VerticalFarmIB3/VerticalFarmIB3.github.io/README.md

Vertical farm - IB3 documentation and webpages
