VerticalFarmIB3/VerticalFarmIB3.github.io/index.md

---
title: Vertical farm - IB3
---

[**Home**](https://verticalfarmib3.github.io/) - [**LEDs and PCB**](/inhoud/leds/) - [**LED Control and Sources**](/inhoud/aansturingLEDs/) - [**Energy Monitoring**](/inhoud/energiemonitoring/) - [**Water Supply**](/inhoud/aquaMonitoring/) - [**Dashboard**](/inhoud/dashboard/) - [**Modularity**](/inhoud/modulariteit/) - [**Plant Sensing**](/inhoud/plantensensor/) - [**Operation**](/inhoud/operation/) - [**Logbook**](/inhoud/logboek/)

---

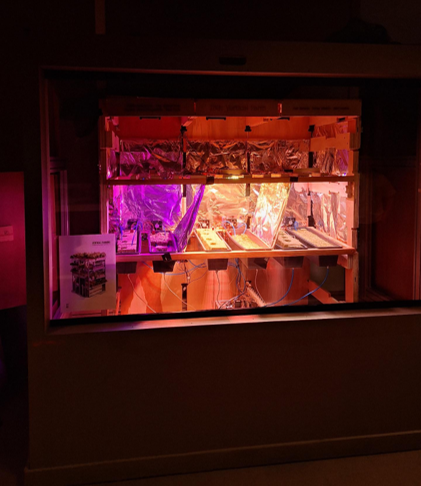
[picture p1: inhoud/images/verticalfarmcloset.png]
