VerticalFarmIB3/VerticalFarmIB3.github.io/inhoud/modulariteit/index.md

---
title: Modularity
---

[**Home**](https://verticalfarmib3.github.io/) - [**LEDs and PCB**](/inhoud/leds/) - [**LED Control and Sources**](/inhoud/aansturingLEDs/) - [**Energy Monitoring**](/inhoud/energiemonitoring/) - [**Water Supply**](/inhoud/aquaMonitoring/) - [**Dashboard**](/inhoud/dashboard/) - [**Modularity**](/inhoud/modulariteit/) - [**Plant Sensing**](/inhoud/plantensensor/) - [**Operation**](/inhoud/operation/) - [**Logbook**](/inhoud/logboek/)

---

The vertical farm is set up in different levels. These are, however, modular and can simply be switched by sliding an entire frame out of a slot. The cables might need to be readjusted, however. A convenient way to increase modularity further could be by working with banana plugs, making every level hot-pluggable.
