VerticalFarmIB3/VerticalFarmIB3.github.io/inhoud/logboek/index.md

---
title: Logbook
---

[**Home**](https://verticalfarmib3.github.io/) - [**LEDs and PCB**](/inhoud/leds/) - [**LED Control and Sources**](/inhoud/aansturingLEDs/) - [**Energy Monitoring**](/inhoud/energiemonitoring/) - [**Water Supply**](/inhoud/aquaMonitoring/) - [**Dashboard**](/inhoud/dashboard/) - [**Modularity**](/inhoud/modulariteit/) - [**Plant Sensing**](/inhoud/plantensensor/) - [**Operation**](/inhoud/operation/) - [**Logbook**](/inhoud/logboek/)

---

13 februari 2024:

* bedrijfsbezoek

20 februari 2024:

* E-mail verzonden voor gratis samples van rockwool bij Grodan
* Opzoeken CO2-sensor
* Tweedehands (oude pc) ventilatoren + aansturing voor planten te laten bewegen
* Info over LEDS gaan vragen bij Jan Audenaert
* LEDs aangestuurd met labovoeding: stroom bepaald (zie [aansturing lampen](/inhoud/aansturingLEDs/))
 * Opzoekwerk buck convertors (geen resultaat)
 * mmol/(m²*s) info opzoeken
 * Opzoekwerk ion-sensoren/ pompmechanismen

27 februari 2024:

 * Laatste opzoekwerk voor CO2-sensor
 * Nieuwe e-mail naar Grodan
 * ESP-home testen
 * Ventilator aansturen met L298N
 * Opzoekwerk buck-convertor
 * DC-motor aansturen voor propeller
 * Bestellingen geplaatst: ()
 * Testen van step-down buck convertor en boost convertor => deze werken en kunnnen gebruikt worden
 * Research homogene mengsels voor nutrient monitoring
 * Impellerrontwerp + starten 3D-print

 5 maart 2024:

* Netstroom naar convertors (230V AC naar 19V/6A DC)
* Desolderen en meten potentiometers
* Opzoekwerk digitale potentiometers (probleem met nauwkeurigheid)
* Poging om Grodan te contacteren

12 maart 2024:

* contactmoment met Grodan
* begonnen aan frame vertical farm
* klaar met LED bediening, wachten totdat erasmusmundus studenten meer weten over specificaties LED's
* Uitlezen en testen van bestelde sensoren
* PCB plantensensoren gemaakt

19 maart 2024:
* PCB plantensensoren aangepast en afgewerkt
* Grafana geimplementeerd in home assistant
* Automatisaties toegevoegd
* PCB water begonnen
* Frame verder gemaakt

26 maart 2024:
* voorbereiden presentatie
* versnellen maakprocess/deadlines

29 maart 2024:
* [deadlines](../deadlines/index.md) gesteld met de uit te voeren taken

1, 2, 3 april:
* maken PCB voor LEDs(Marta Pozzi & Hayato Nakanishi)
* maken PCB voor LEDs(Yuta & Jualiang)
* PCB's bestellen
* scherm uittesten + raspberry pi herconfiguren (ESPhome, homeassist en mosquitto in dockers steken)
* pcb voor grond, co2 en temperatuursensoren solderen en testen
* opzoekwerk naar ideale waarden paprika en basilicum (temperatuur, luchtvochtigheid, co2, grondvochtigheid)

16 april:
* solderen en uittesten van PCB voor LEDs(Marta Pozzi & Hayato Nakanishi)
* solderen en uittesten van PCB voor LEDs(Yuta & Jualiang)
* solderen en uittesten relais bord voor ventilatorensturing (werkt nog niet)
* op oude home assistant MQTT uitgetest met ESP
* ionen voeding
* ....
* studie uitvoeren voor ontwikkeling van PCB vermogenslogger

23 april:
* testen relais bord voor ventilatorensturing
* hardware beginnen installeren in de kast
* LED drivers selecteren en bestellen
* Ontwikkeling van PCB vermogenslogger en schakelaar
* Bestelling van compontenten voor vermogenslogger

30 april:
* 2 extra bordjes gemaakt voor grondsensor, co2 sensor en luchtvochtigheidssensor
* bordjes programmeren
* pcb's geïnstalleerd in de kast
* installatie LED-arrays en LED-drivers (zorgen voor een volledige cablatie)
* kast voorzien van nodige flexibiliteit qua lichtverdeling

7 mei:
* kabelmanagement in de kast
* grafana + influxDB geïnstalleerd op Pi en setup ervan
* eerste dashboard grafana gemaakt
* solderen LED-array PCB Muneeb
* solderen van vermogenslogger PCB + eerste programmatie om de verschillende onderdelen te testen

8 mei:
* solderen bordjes Muneeb + installatie
* programmatie van een eerste implementatie van de vermogenslogger PCB

10 mei:
* volledige implementatie van de vermogenslogger PCB (correcte cablatie met de de led-drivers)
* het uittesten van correct af/uit schakeling + correcte stroommeting

14 mei:
* Voedingen verbonden 

16 mei:
* !presentatie!
