VerticalFarmIB3/VerticalFarmIB3.github.io/inhoud/energiemonitoring/Blokschema.png

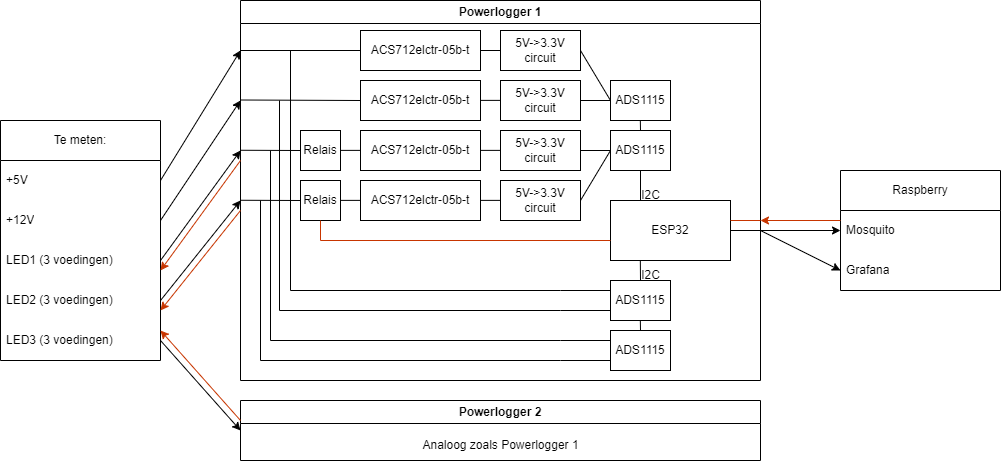
inhoud/energiemonitoring/Blokschema.png
