VerticalFarmIB3/VerticalFarmIB3.github.io/inhoud/energiemonitoring/bordje.jpg

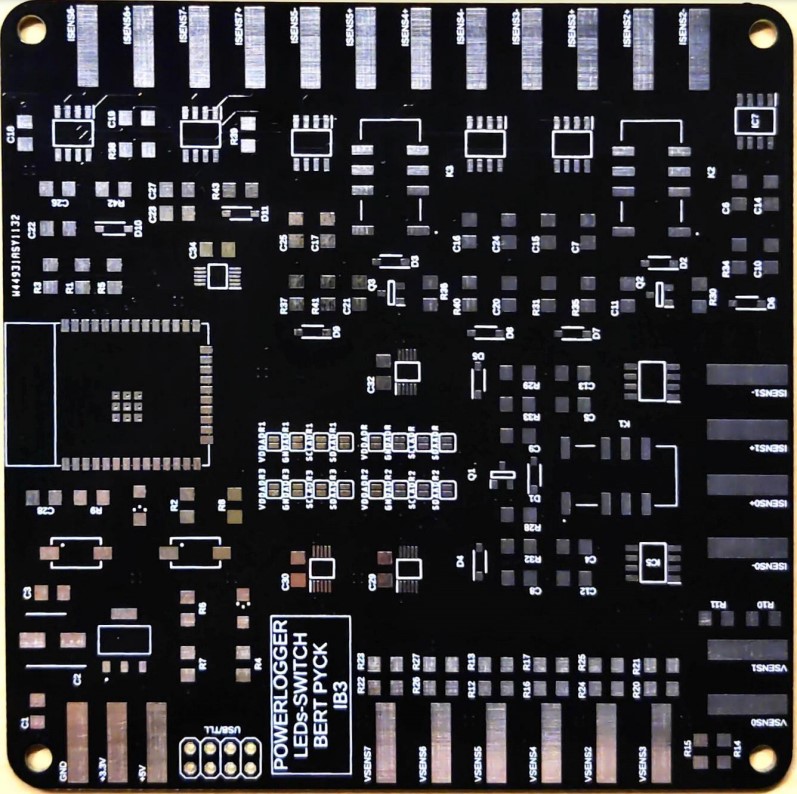
inhoud/energiemonitoring/bordje.jpg
