VerticalFarmIB3/VerticalFarmIB3.github.io/inhoud/energiemonitoring/leds.bmp

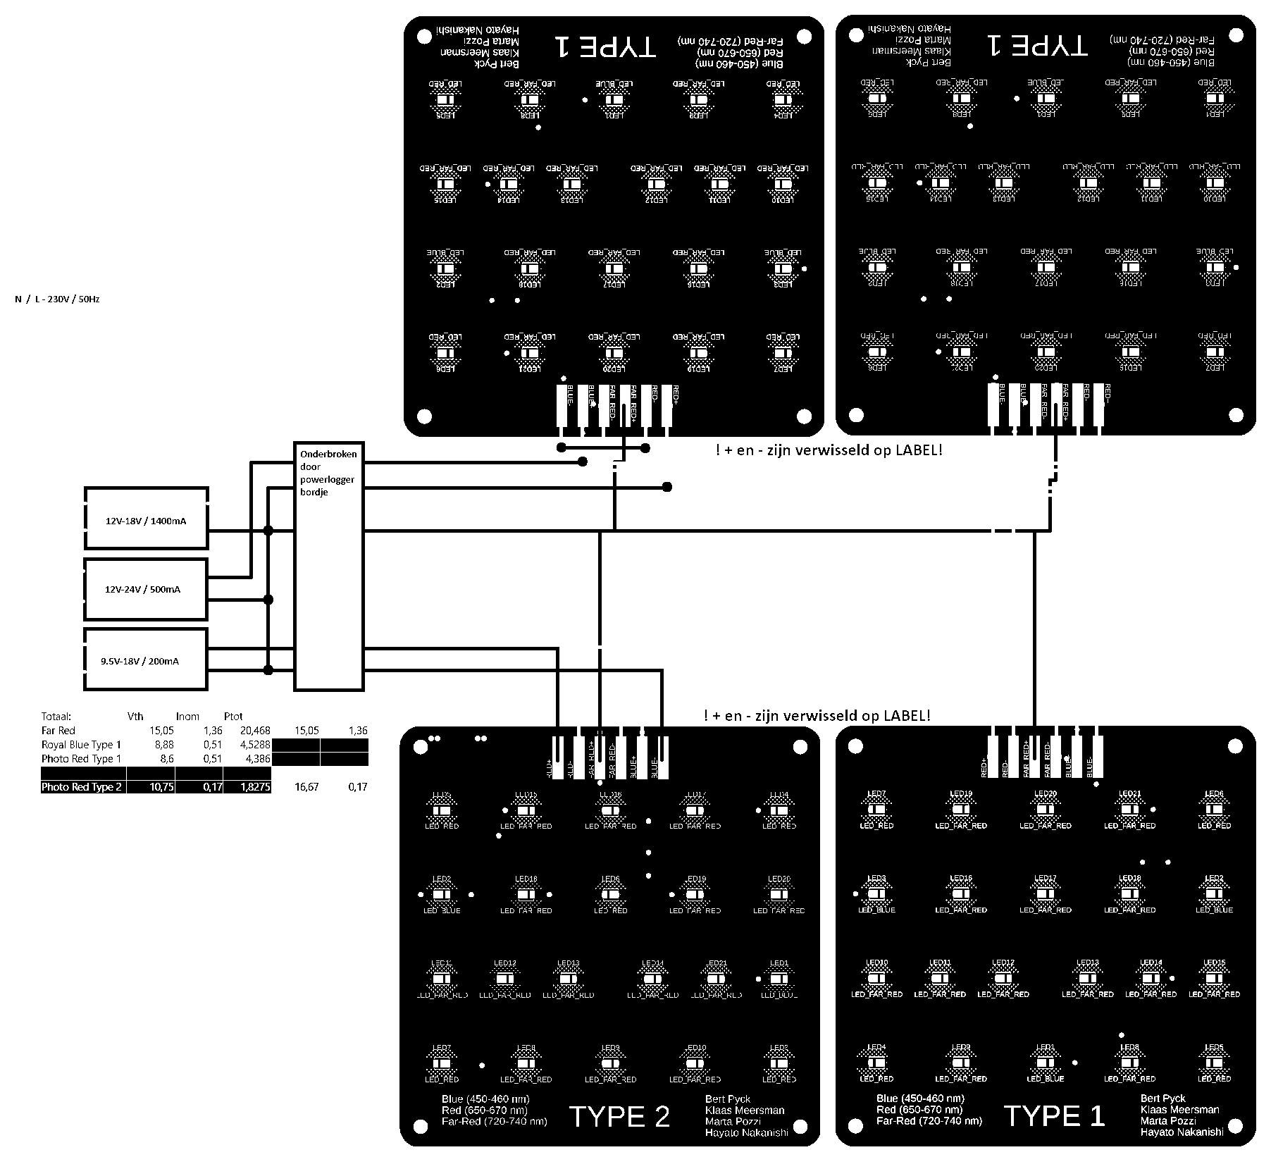
inhoud/energiemonitoring/leds.bmp
