VerticalFarmIB3/VerticalFarmIB3.github.io/inhoud/energiemonitoring/pcb.jpg

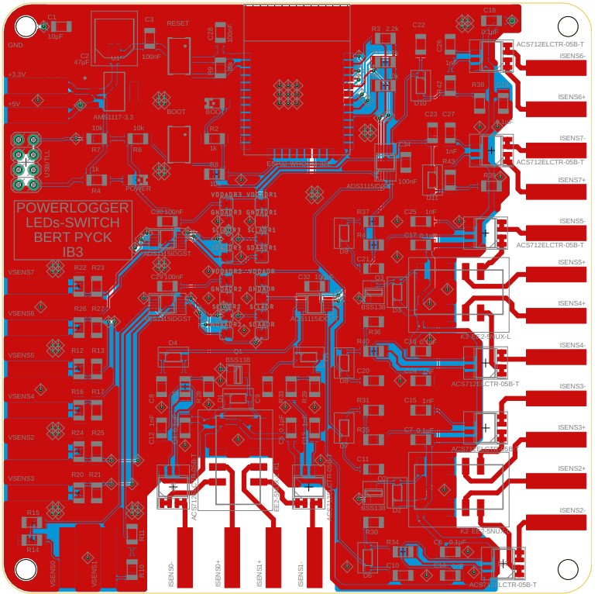
inhoud/energiemonitoring/pcb.jpg
