VerticalFarmIB3/VerticalFarmIB3.github.io/inhoud/energiemonitoring/PCBs Bert (Type1, Type2, Powerlogger)/Type2/Type2afb.png

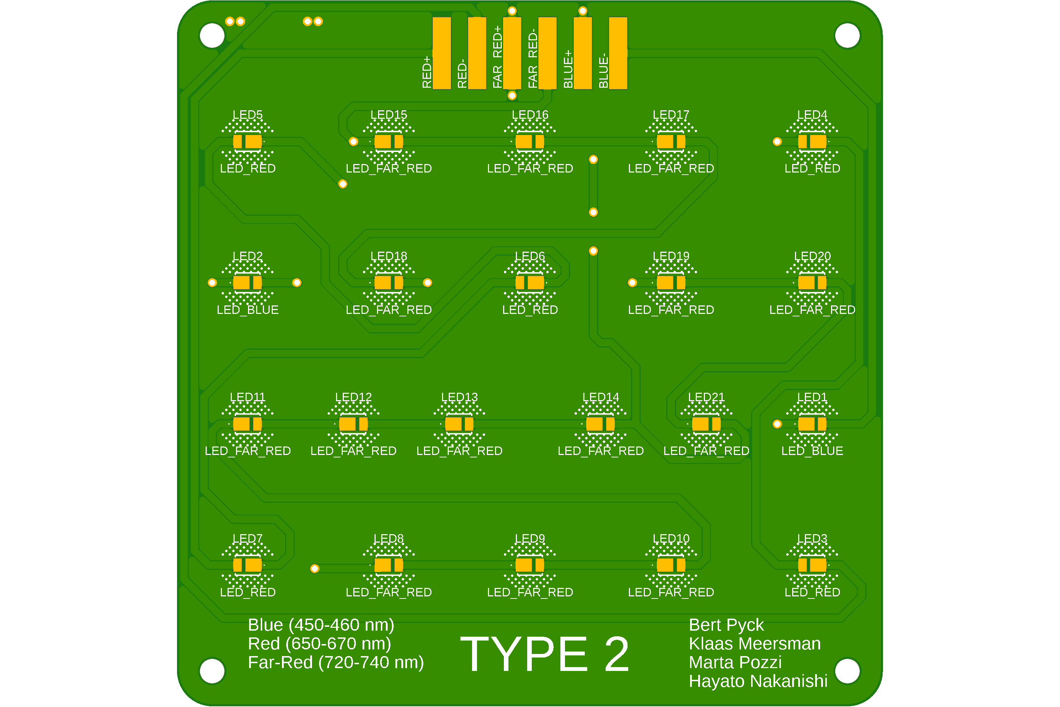
inhoud/energiemonitoring/PCBs Bert (Type1, Type2, Powerlogger)/Type2/Type2afb.png
