VerticalFarmIB3/VerticalFarmIB3.github.io/inhoud/images/mindmap.png

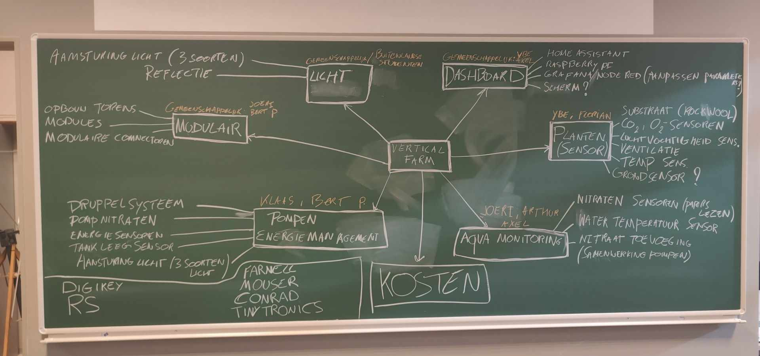
inhoud/images/mindmap.png
