VerticalFarmIB3/VerticalFarmIB3.github.io/inhoud/plantensensor/PCB Plantsensing/PCB_plantensensor.png

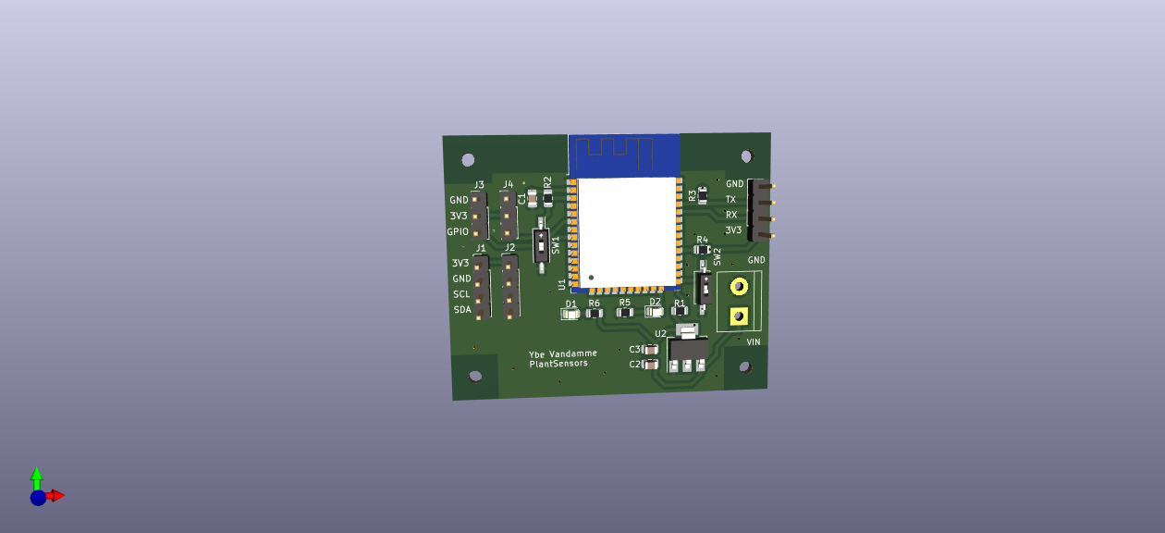
inhoud/plantensensor/PCB Plantsensing/PCB_plantensensor.png
