VerticalFarmIB3/VerticalFarmIB3.github.io/inhoud/bestellingen/Bestellingslijst.xlsx

COMPONENTEN | ACTIE | AANTAL | PRIJS(€) | INFO | LINK | TOTAAL: | 180.65 | €
perestalische pomp | besteld | 9 | 5 | pomp voor het water uit de vistank naar de testtank | Peristaltische Pomp PYSP310-6A - 6V - PYSP310-6A (tinytronics.nl) (https://www.tinytronics.nl/nl/mechanica-en-actuatoren/motoren/pompen/peristaltische-pomp-pysp310-6a-6v)
lichtsensor | kopen | 1 | 0 | water testen
elektrische valve | besteld | 1 | 6.46 | testtank laten leeglopen na de test | 997 Adafruit | Mouser Belgium (https://www.mouser.be/ProductDetail/Adafruit/997?qs=GURawfaeGuCTiqiBcfTxFg%3D%3D)
mengmotor | IN BEZIT | 1 | 0 | water uit de vistank mengen om alles in evenwicht te houden
dumpsensor | IN BEZIT | 1 | 0 | waterniveau van de dump
ISE-2922 NO3- | besteld | 1 | 36.83 | PRIJS VARIABEL DOOR TYPE BESTELLING | preview (alibaba.com) (https://clouddisk.alibaba.com/file/preview.htm?appkey=OneChat&id=2318195343&parentId=2318195342&scene=1)
ISE-2923 Ca2+ | besteld | 1 | 27.62 | PRIJS VARIABEL DOOR TYPE BESTELLING | Pca-1 Calcium Ion Selective Sensor Bnc Connector Pvc Shell Calcium Ion Selective Electrode Probe In Hard Water Quality Testing - Buy Ion Selective Sensor,Ion Selective Sensor,Ion Selective Sensor Product on Alibaba.com (https://www.alibaba.com/product-detail/PCa-1-Calcium-ion-Selective-sensor_60699746432.html)
ISE-2920 K+ | besteld | 1 | 32.22 | PRIJS VARIABEL DOOR TYPE BESTELLING | Ise K+ Potassium Ion Selective Electrode - Buy Potassium,Ion Selective,Electrode Product on Alibaba.com (https://www.alibaba.com/product-detail/ISE-K-potassium-ion-selective-electrode_1600225607843.html)
pvc-buis | kopen | 1 | 0
flexibuis | besteld | 2 | 3.26 | vistank verbinden met testtank | 3659 Adafruit | Mouser Belgium (https://www.mouser.be/ProductDetail/Adafruit/3659?qs=rrS6PyfT74cHSKykPv5TjQ%3D%3D)
bodemvochtsensor | besteld | 1 | 4 |  | Capacitieve Bodemvochtsensor Module met Kabel - SOILMOISWCABLE (tinytronics.nl) (https://www.tinytronics.nl/nl/sensoren/vloeistof/capacitieve-bodemvocht-sensor-module-met-kabel)
GY-SCD40 Module | besteld | 1 | 22 | GY-SCD40 Module - CO2- Luchtvochtigheid- en Temperatuursensor - I2C
