VerticalFarmIB3/VerticalFarmIB3.github.io/inhoud/energiemonitoring/PCBs Bert (Type1, Type2, Powerlogger)/Type1/Type1sch.pdf

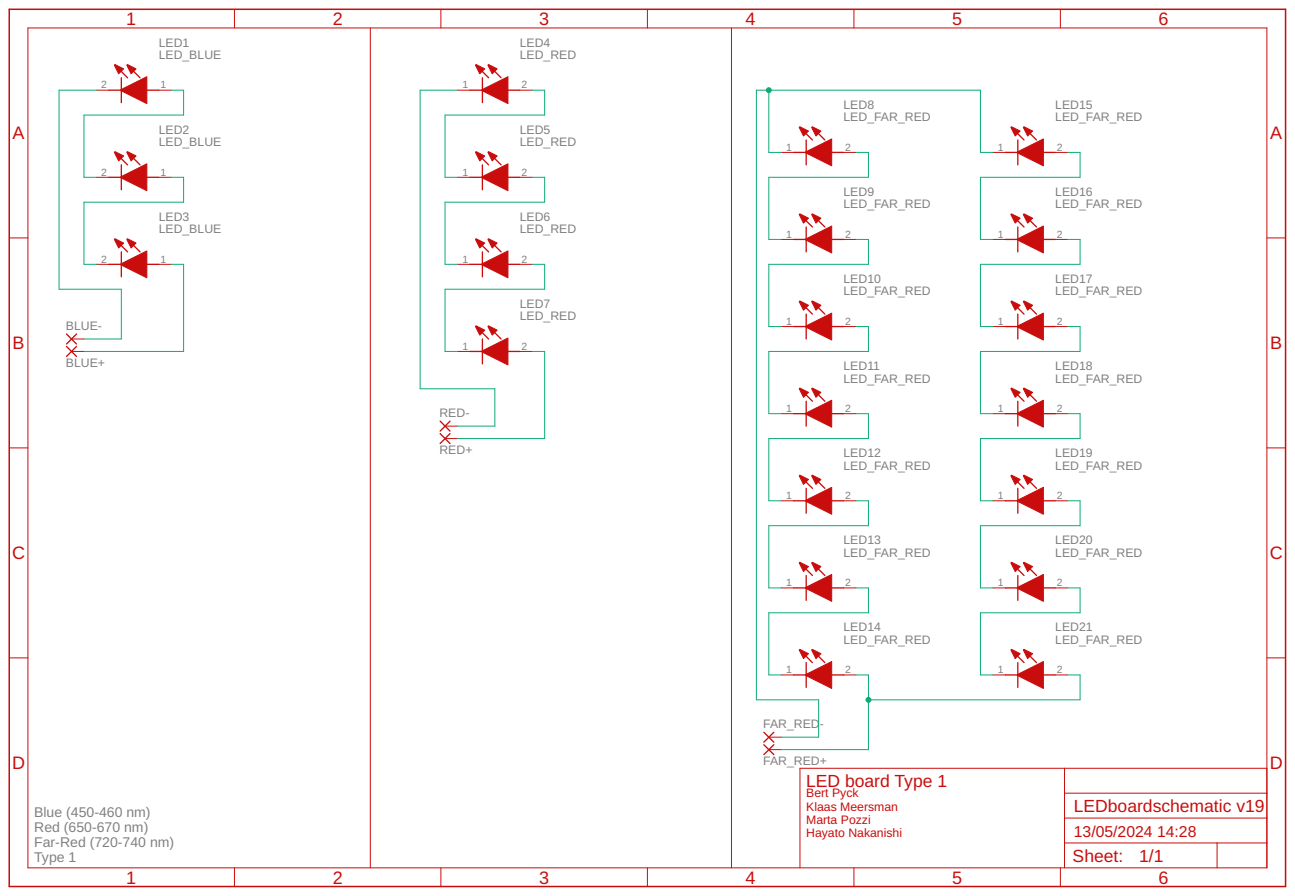
[picture p56: page 1]

LED1 | LED4

Bert Pyck Klaas Meersman Marta Pozzi Hayato Nakanishi

Sheet: 1/1
