VerticalFarmIB3/VerticalFarmIB3.github.io/inhoud/plantensensor/PCB Plantsensing/schematic.pdf

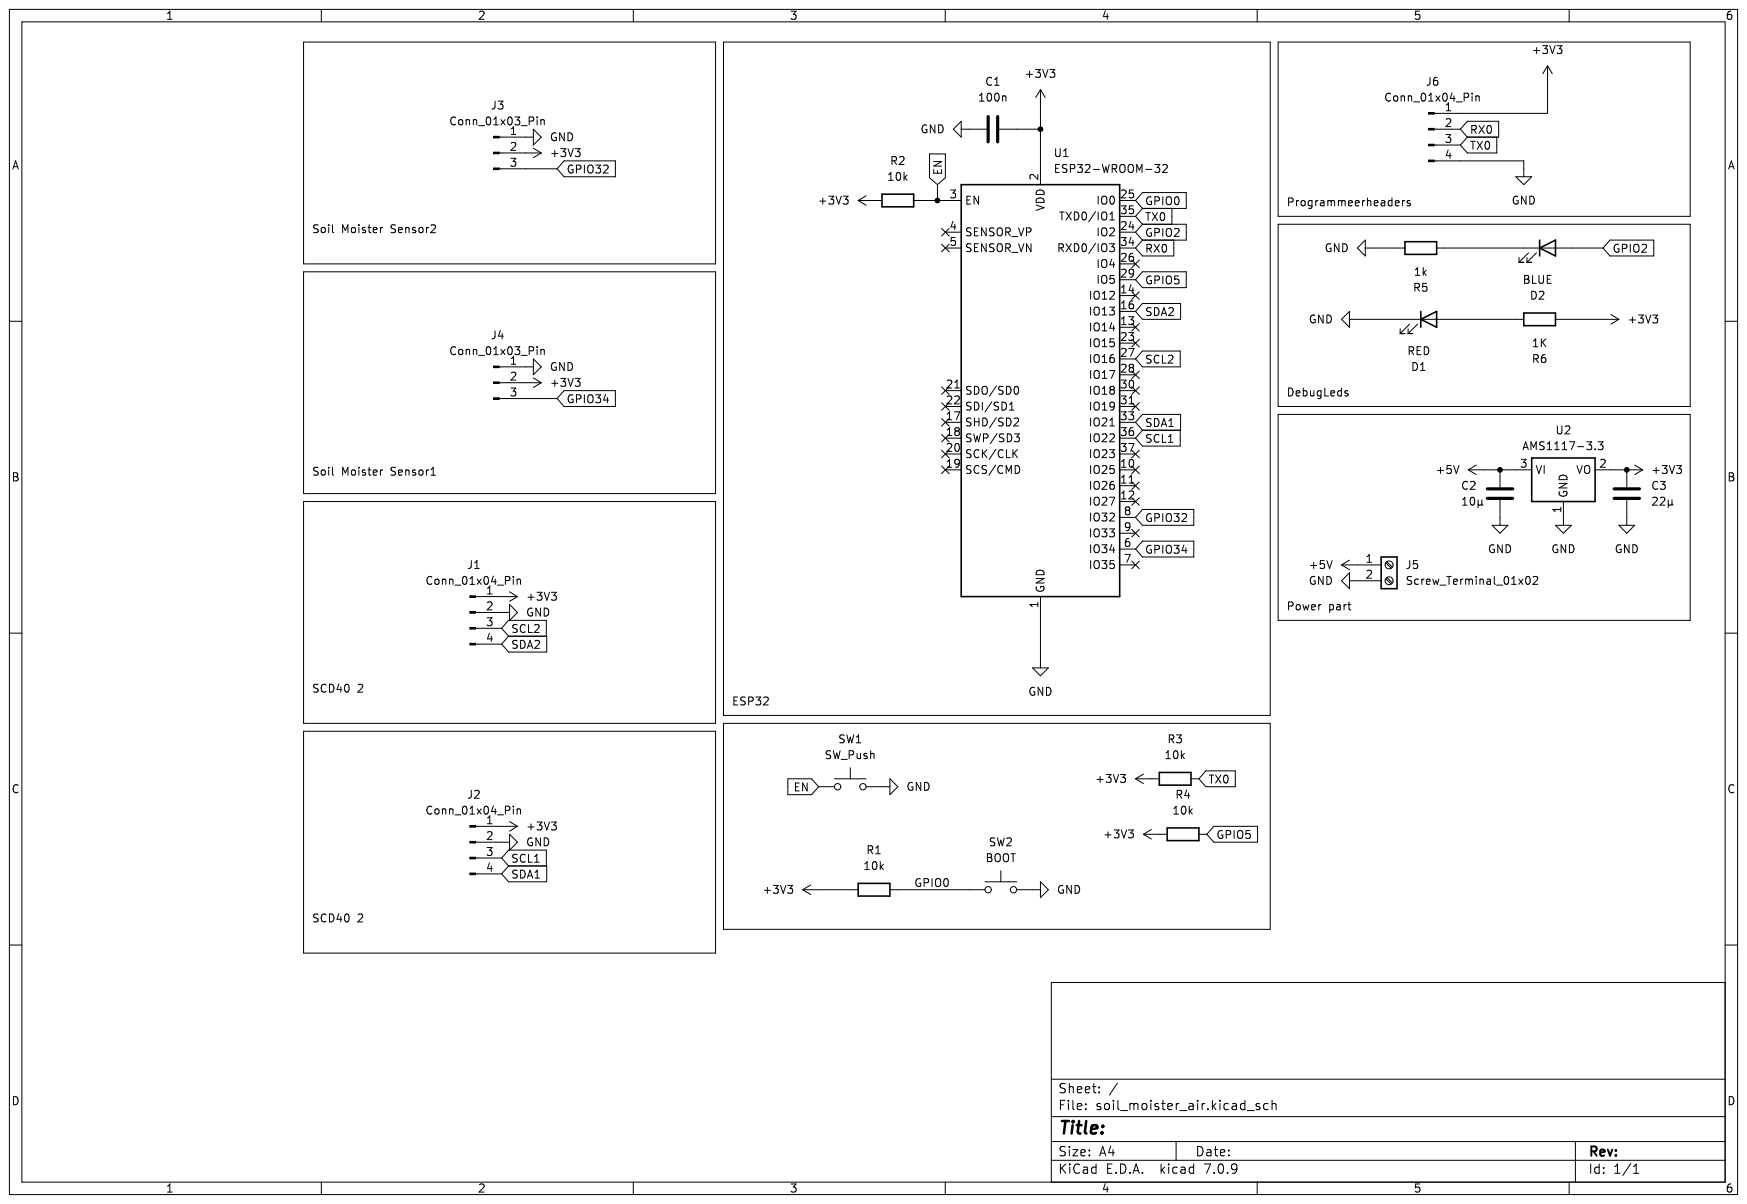
[picture p57: page 1]
