VerticalFarmIB3/VerticalFarmIB3.github.io/inhoud/aansturingLEDs/PowerloggerBrd.pdf

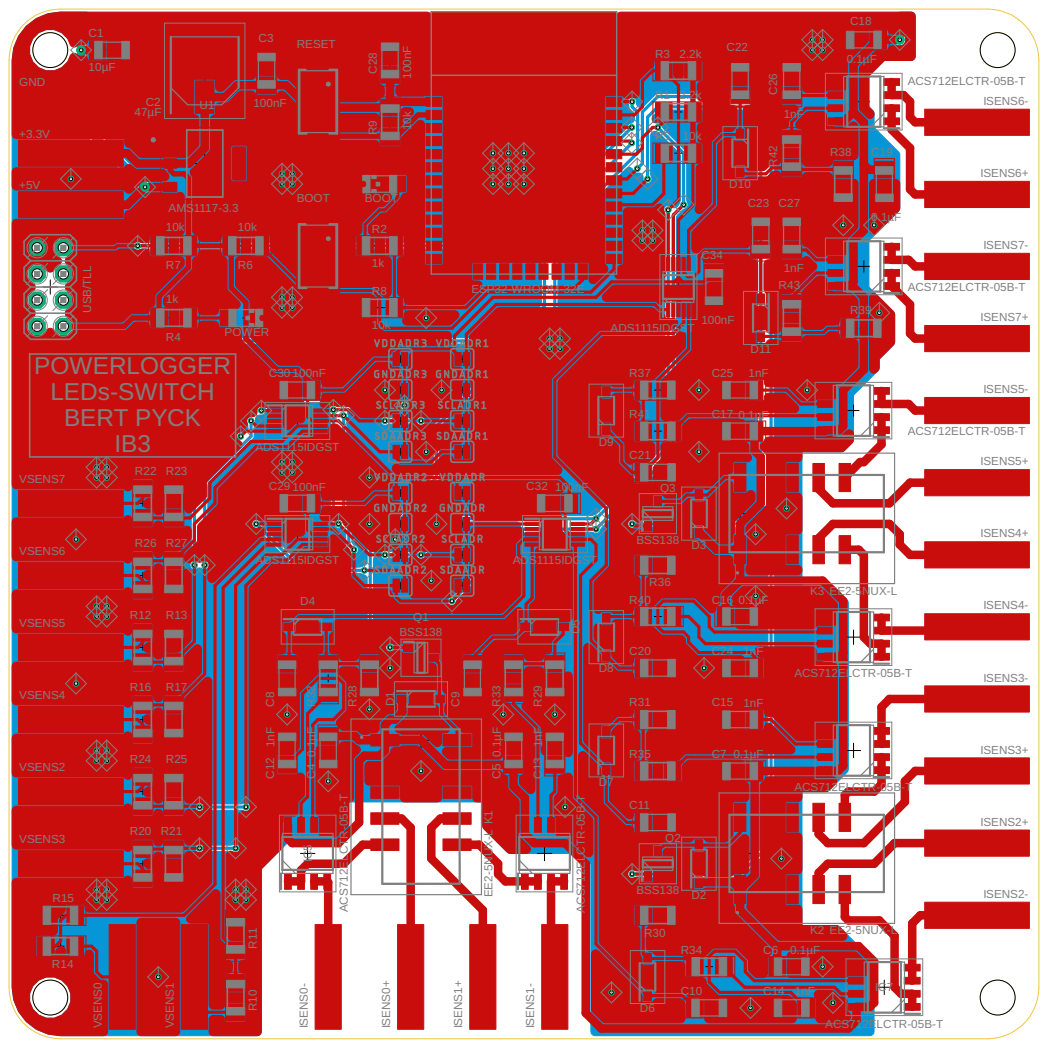
[picture p58: page 1]

BSS138
