VerticalFarmIB3/VerticalFarmIB3.github.io/inhoud/energiemonitoring/PCBs Bert (Type1, Type2, Powerlogger)/PowerLogger/PowerloggerSch.pdf

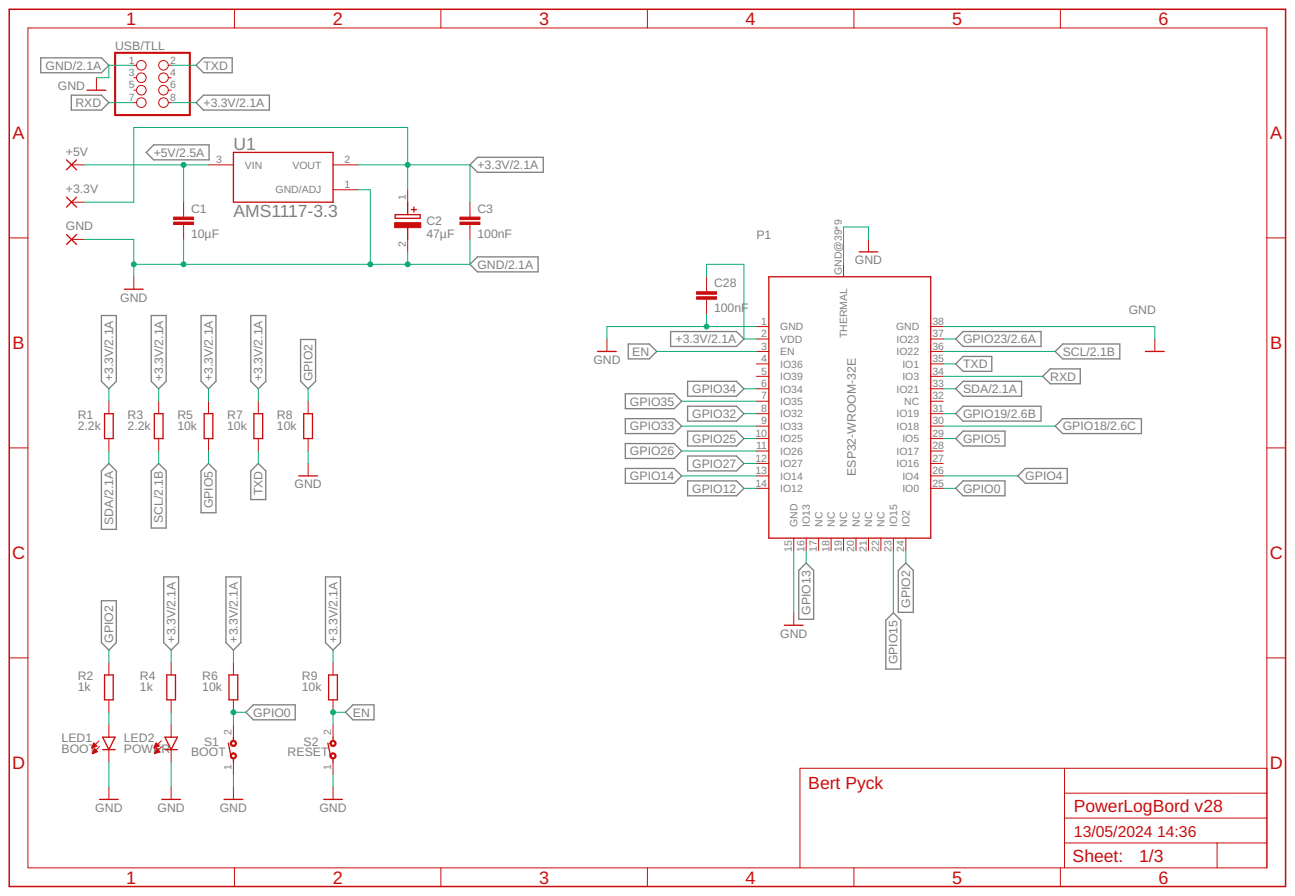
[picture p59: page 1]

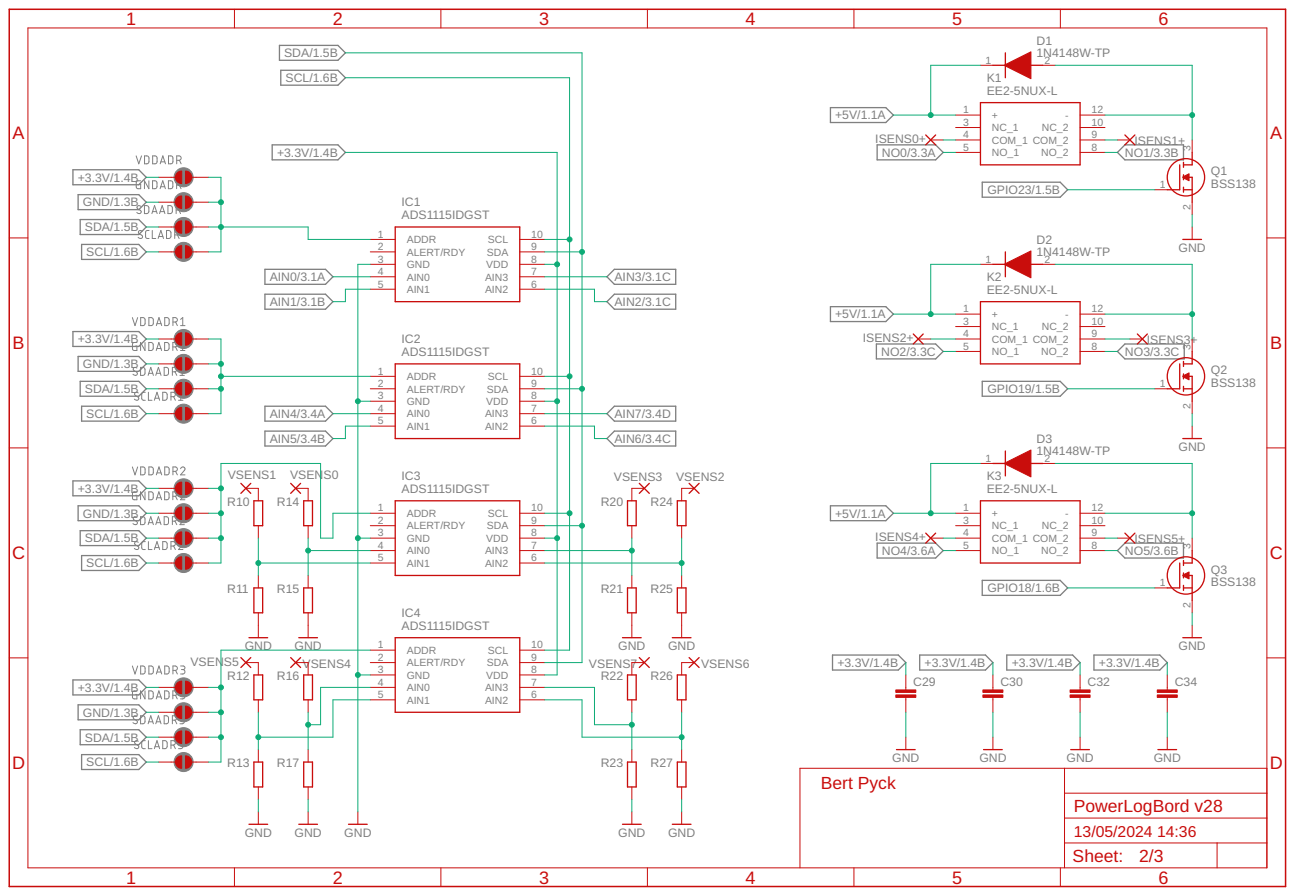
[picture p60: page 2]

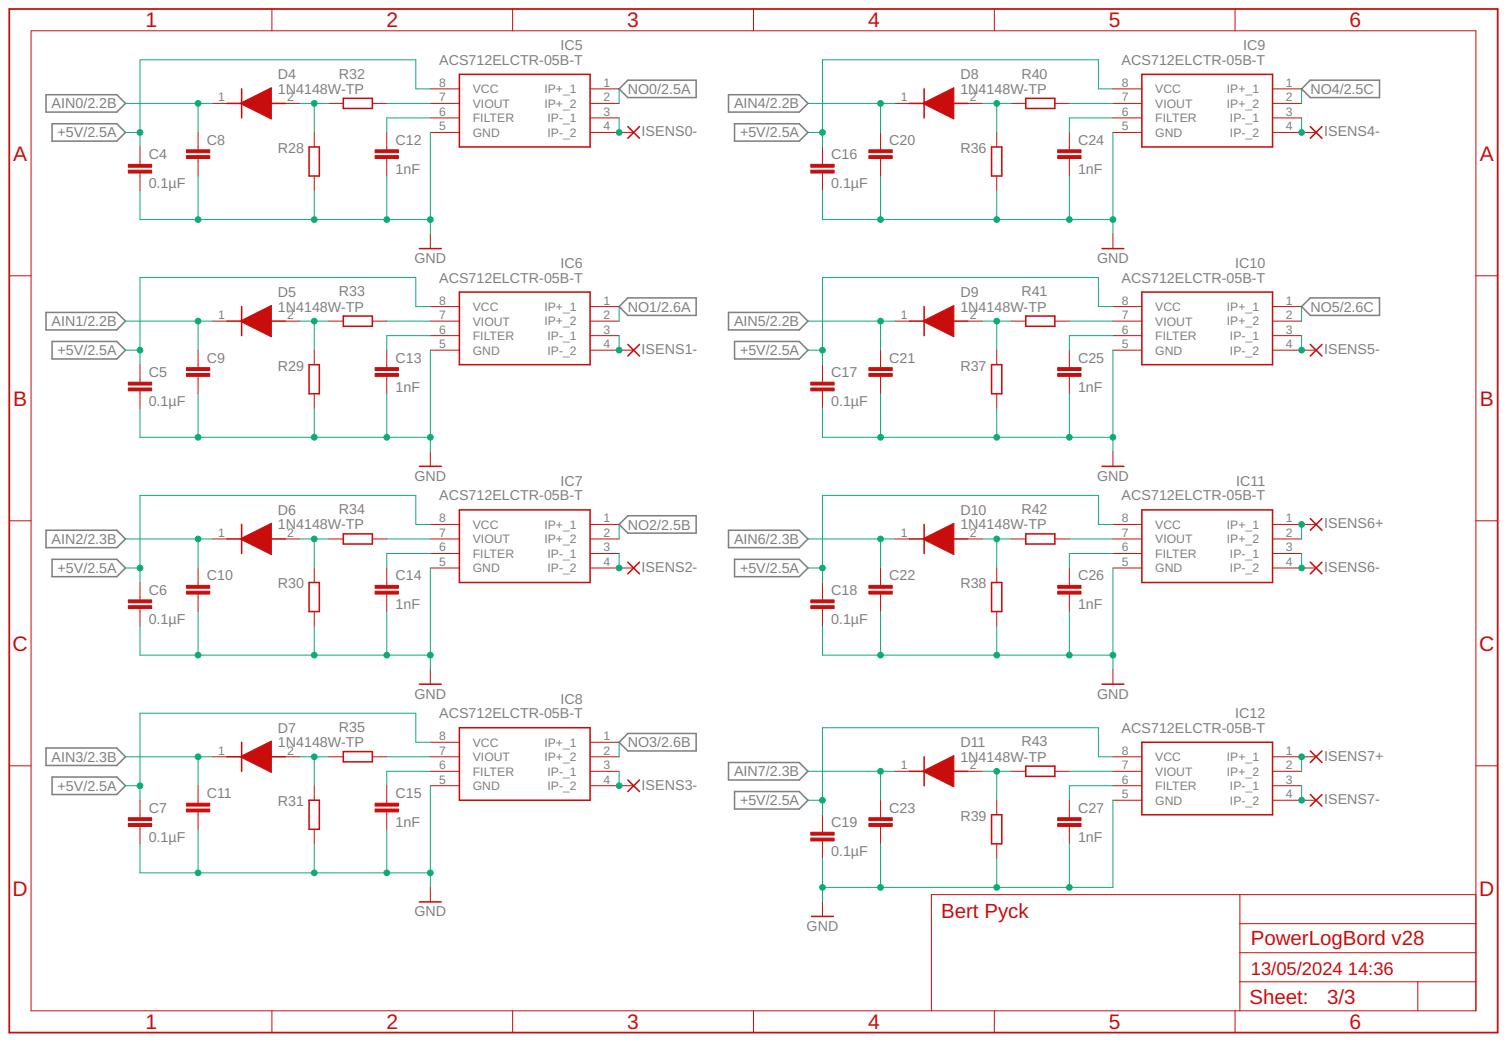
[picture p61: page 3]

Bert Pyck

Sheet: 3/3
