VerticalFarmIB3/VerticalFarmIB3.github.io/inhoud/energiemonitoring/PCBs Bert (Type1, Type2, Powerlogger)/Type1/Type1brd.pdf

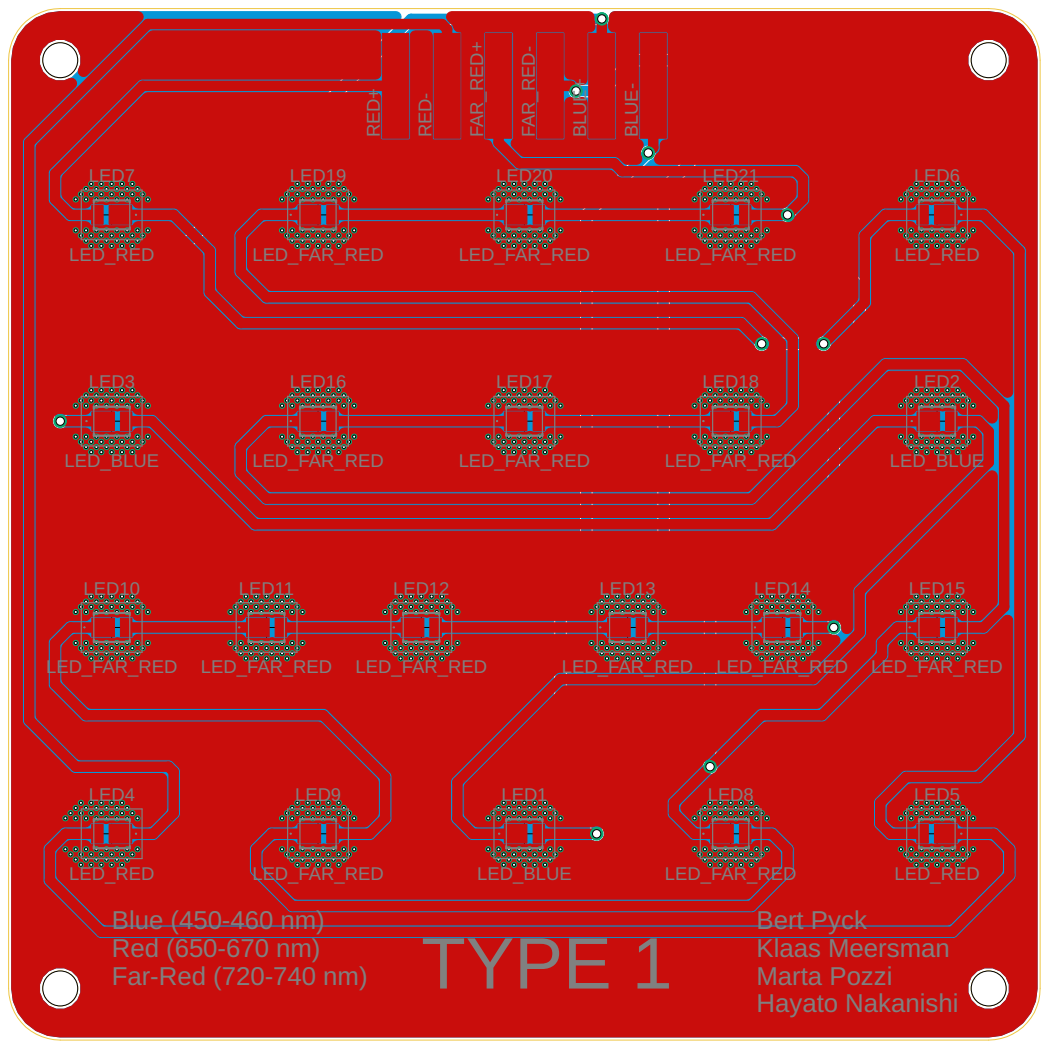
[picture p62: page 1]

Bert Pyck
Klaas Meersman Marta Pozzi
