VerticalFarmIB3/VerticalFarmIB3.github.io/inhoud/energiemonitoring/PCBs Bert (Type1, Type2, Powerlogger)/Type2/Type2brd.pdf

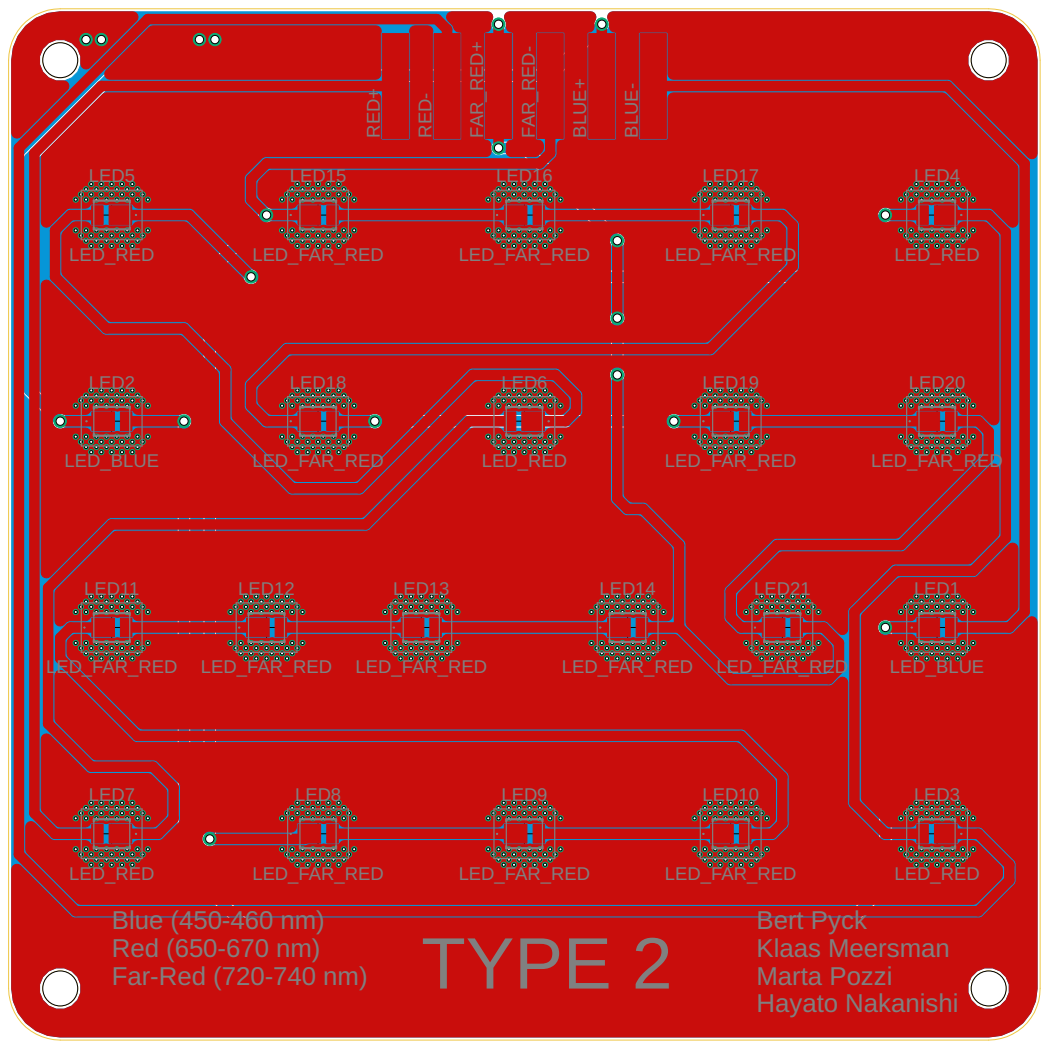
[picture p63: page 1]

Bert Pyck
Klaas Meersman Marta Pozzi
