VerticalFarmIB3/VerticalFarmIB3.github.io/inhoud/plantensensor/PCB Plantsensing/soil_moister_air/soil_moister_air.kicad_pcb

## KiCad design inhoud/plantensensor/PCB Plantsensing/soil_moister_air/soil_moister_air.kicad_pcb (2024-05-24)

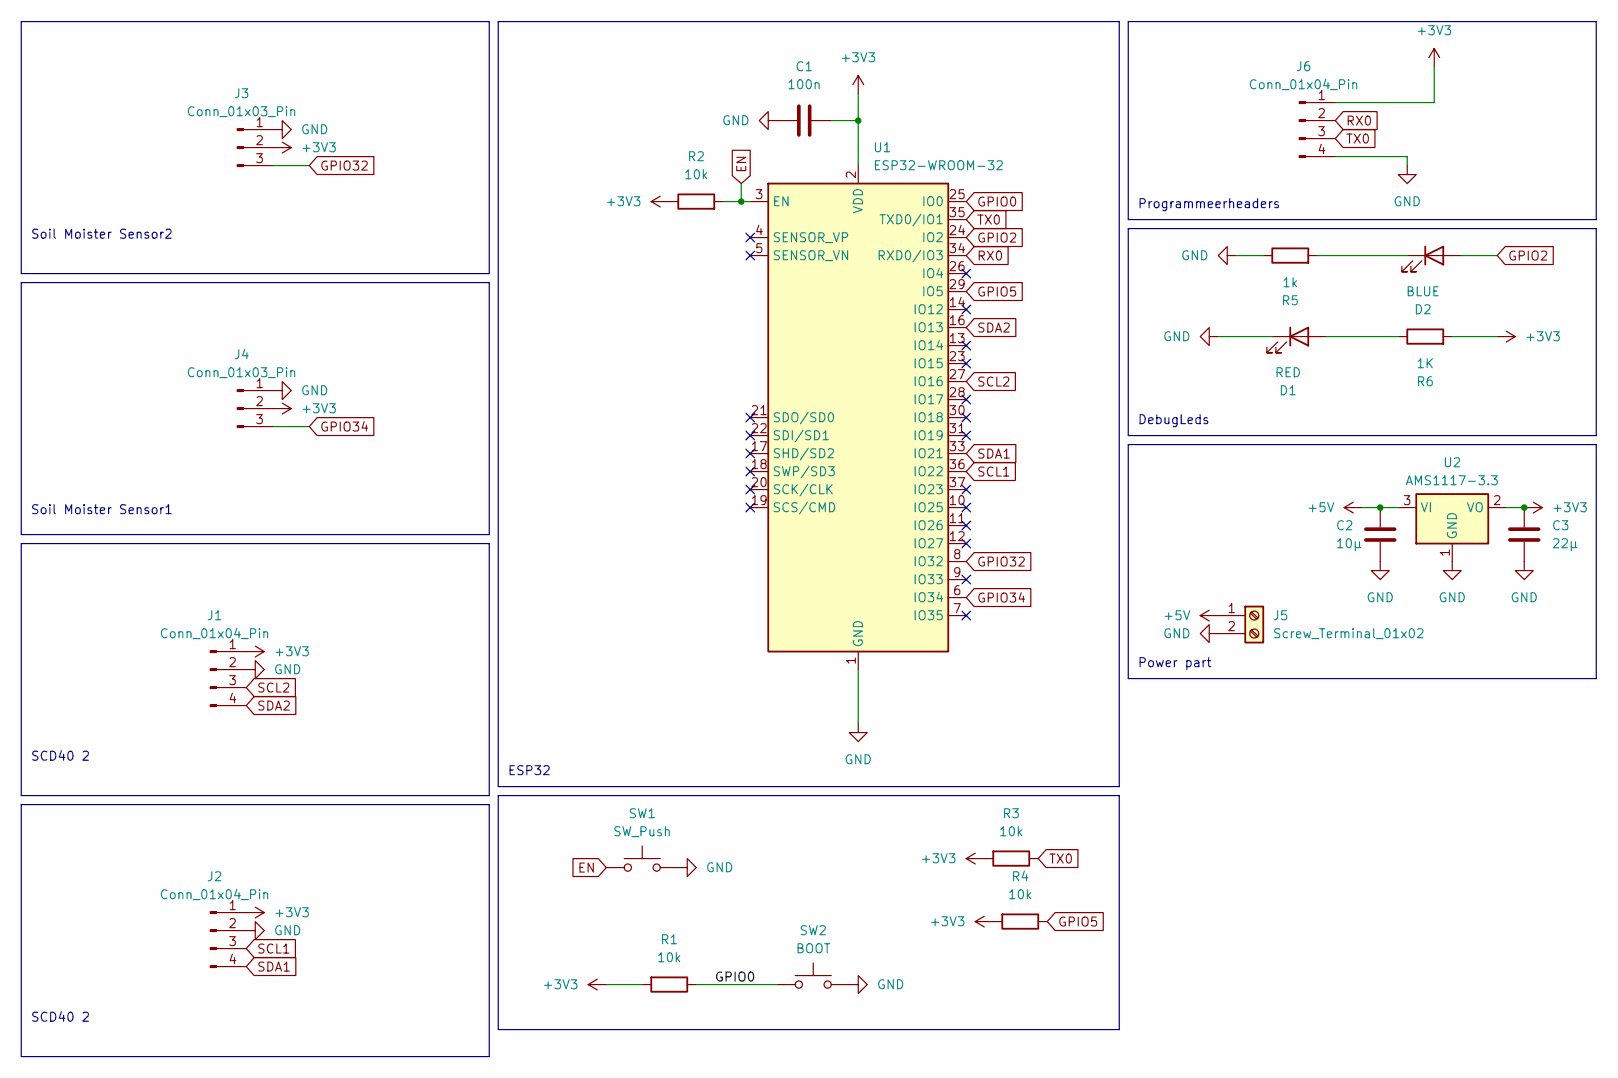
[picture p65: schematic soil_moister_air.kicad_sch]

Parts:
C1: 100n; C_0805_2012Metric
C2: 10µ; C_0805_2012Metric
C3: 22µ; C_0805_2012Metric
D1: RED; LED_0805_2012Metric
D2: BLUE; LED_0805_2012Metric
J1, J2, J6: Conn_01x04_Pin; PinHeader_1x04_P2.54mm_Vertical
J3, J4: Conn_01x03_Pin; PinHeader_1x03_P2.54mm_Vertical
J5: Screw_Terminal_01x02; TerminalBlock_bornier-2_P5.08mm
R1, R2, R3, R4: 10k; R_0805_2012Metric
R5: 1k; R_0805_2012Metric
R6: 1K; R_0805_2012Metric
SW1: SW_Push; SW_DIP_SPSTx01_Slide_Copal_CHS-01B_W7.62mm_P1.27mm
SW2: BOOT; SW_DIP_SPSTx01_Slide_Copal_CHS-01B_W7.62mm_P1.27mm
U1: ESP32-WROOM-32
U2: AMS1117-3.3; SOT-223-3_TabPin2

Connections:
+3V3: C1.2, C3.1, J1.1, J2.1, J3.2, J4.2, J6.1, R1.2, R2.1, R3.2, R4.2, R6.2, U1.2 (VDD), U2.2 (VO)
+5V: C2.1, J5.1, U2.3 (VI)
EN: R2.2, SW1.1, U1.3 (EN)
GND: C1.1, C2.2, C3.2, D1.1 (K), J1.2, J2.2, J3.1, J4.1, J5.2, J6.4, R5.1, SW1.2, SW2.2, U1.1 (GND), U1.15 (GND), U1.38 (GND), U1.39 (GND), U2.1 (GND)
GPIO0: R1.1, SW2.1, U1.25 (IO0)
GPIO2: D2.2 (A), U1.24 (IO2)
GPIO5: R4.1, U1.29 (IO5)
GPIO32: J3.3, U1.8 (IO32)
GPIO34: J4.3, U1.6 (IO34)
unnamed: D1.2 (A), R6.1
unnamed: D2.1 (K), R5.2
RX0: J6.2, U1.34 (RXD0/IO3)
SCL1: J2.3, U1.36 (IO22)
SCL2: J1.3, U1.27 (IO16)
SDA1: J2.4, U1.33 (IO21)
SDA2: J1.4, U1.16 (IO13)
TX0: J6.3, R3.1, U1.35 (TXD0/IO1)

Notes on the sheet:
DebugLeds
Soil Moister Sensor1
Soil Moister Sensor2
Programmeerheaders
SCD40 2
ESP32
Power part

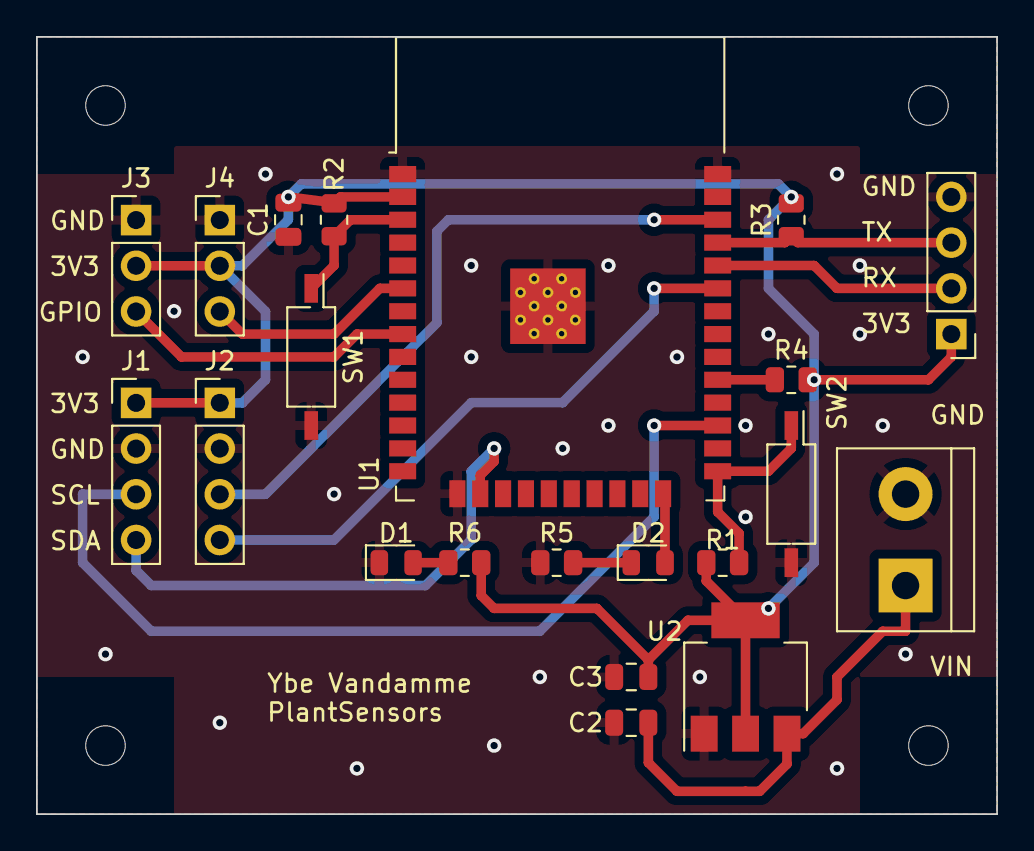
[picture p66: board soil_moister_air.kicad_pcb from above]

Board: 2 copper layers, 53.3 x 43.2 mm, 21 parts (0 on the bottom side), 17 nets.
