VerticalFarmIB3/VerticalFarmIB3.github.io/inhoud/leds/eaglefiles/yuta_jualiang/YutaAndJialiang v19.brd

## EAGLE design inhoud/leds/eaglefiles/yuta_jualiang/YutaAndJialiang v19.brd (2024-05-24)

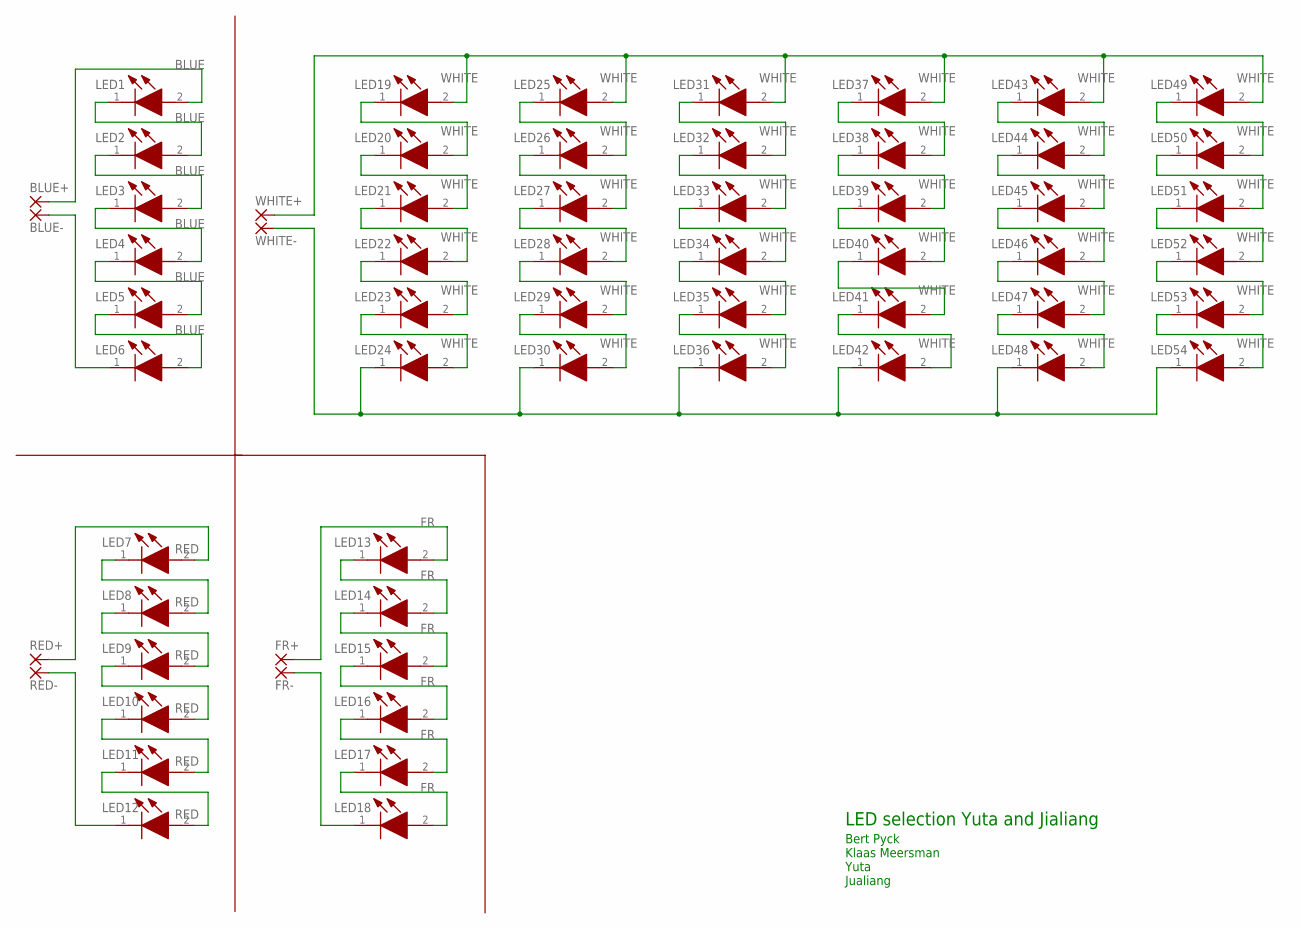
[picture p67: schematic YutaAndJialiang v17.sch]

Parts:
BLUE+: SOLDERPAD
BLUE-: SOLDERPAD
FR+: SOLDERPAD
FR-: SOLDERPAD
LED1, LED2, LED3, LED4, LED5, LED6: BLUE; L1SP-PNK1002800000
LED7, LED8, LED9, LED10, LED11, LED12: RED; L1SP-PNK1002800000
LED13, LED14, LED15, LED16, LED17, LED18: FR; L1SP-PNK1002800000
LED19, LED20, LED21, LED22, LED23, LED24, LED25, LED26, LED27, LED28, LED29, LED30, LED31, LED32, LED33, LED34, LED35, LED36, LED37, LED38, LED39, LED40, LED41, LED42, LED43, LED44, LED45, LED46, LED47, LED48, LED49, LED50, LED51, LED52, LED53, LED54: WHITE; L1SP-PNK1002800000
RED+: SOLDERPAD
RED-: SOLDERPAD
WHITE+: SOLDERPAD
WHITE-: SOLDERPAD

Connections:
unnamed: LED7.2 (A), RED+.1
unnamed: LED28.1 (K), LED29.2 (A)
unnamed: LED7.1 (K), LED8.2 (A)
unnamed: LED8.1 (K), LED9.2 (A)
unnamed: LED9.1 (K), LED10.2 (A)
unnamed: LED10.1 (K), LED11.2 (A)
unnamed: LED11.1 (K), LED12.2 (A)
unnamed: BLUE-.1, LED6.1 (K)
unnamed: FR+.1, LED13.2 (A)
unnamed: LED19.2 (A), LED25.2 (A), LED31.2 (A), LED37.2 (A), LED43.2 (A), LED49.2 (A), WHITE+.1
unnamed: LED24.1 (K), LED30.1 (K), LED36.1 (K), LED42.1 (K), LED48.1 (K), LED54.1 (K), WHITE-.1
unnamed: LED19.1 (K), LED20.2 (A)
unnamed: LED29.1 (K), LED30.2 (A)
unnamed: LED20.1 (K), LED21.2 (A)
unnamed: LED21.1 (K), LED22.2 (A)
unnamed: LED22.1 (K), LED23.2 (A)
unnamed: LED13.1 (K), LED14.2 (A)
unnamed: LED14.1 (K), LED15.2 (A)
unnamed: LED15.1 (K), LED16.2 (A)
unnamed: LED16.1 (K), LED17.2 (A)
unnamed: LED17.1 (K), LED18.2 (A)
unnamed: LED23.1 (K), LED24.2 (A)
unnamed: FR-.1, LED18.1 (K)
unnamed: LED25.1 (K), LED26.2 (A)
unnamed: LED26.1 (K), LED27.2 (A)
unnamed: LED27.1 (K), LED28.2 (A)
unnamed: LED12.1 (K), RED-.1
unnamed: LED31.1 (K), LED32.2 (A)
unnamed: LED32.1 (K), LED33.2 (A)
unnamed: BLUE+.1, LED1.2 (A)
unnamed: LED1.1 (K), LED2.2 (A)
unnamed: LED2.1 (K), LED3.2 (A)
unnamed: LED3.1 (K), LED4.2 (A)
unnamed: LED4.1 (K), LED5.2 (A)
unnamed: LED5.1 (K), LED6.2 (A)
unnamed: LED33.1 (K), LED34.2 (A)
unnamed: LED34.1 (K), LED35.2 (A)
unnamed: LED35.1 (K), LED36.2 (A)
unnamed: LED37.1 (K), LED38.2 (A)
unnamed: LED38.1 (K), LED39.2 (A)
unnamed: LED39.1 (K), LED40.2 (A)
unnamed: LED40.1 (K), LED41.2 (A)
unnamed: LED41.1 (K), LED42.2 (A)
unnamed: LED43.1 (K), LED44.2 (A)
unnamed: LED44.1 (K), LED45.2 (A)
unnamed: LED45.1 (K), LED46.2 (A)
unnamed: LED46.1 (K), LED47.2 (A)
unnamed: LED47.1 (K), LED48.2 (A)
unnamed: LED49.1 (K), LED50.2 (A)
unnamed: LED50.1 (K), LED51.2 (A)
unnamed: LED51.1 (K), LED52.2 (A)
unnamed: LED52.1 (K), LED53.2 (A)
unnamed: LED53.1 (K), LED54.2 (A)

Notes on the sheet:
LED selection Yuta and Jialiang
Bert Pyck Klaas Meersman Yuta Jualiang

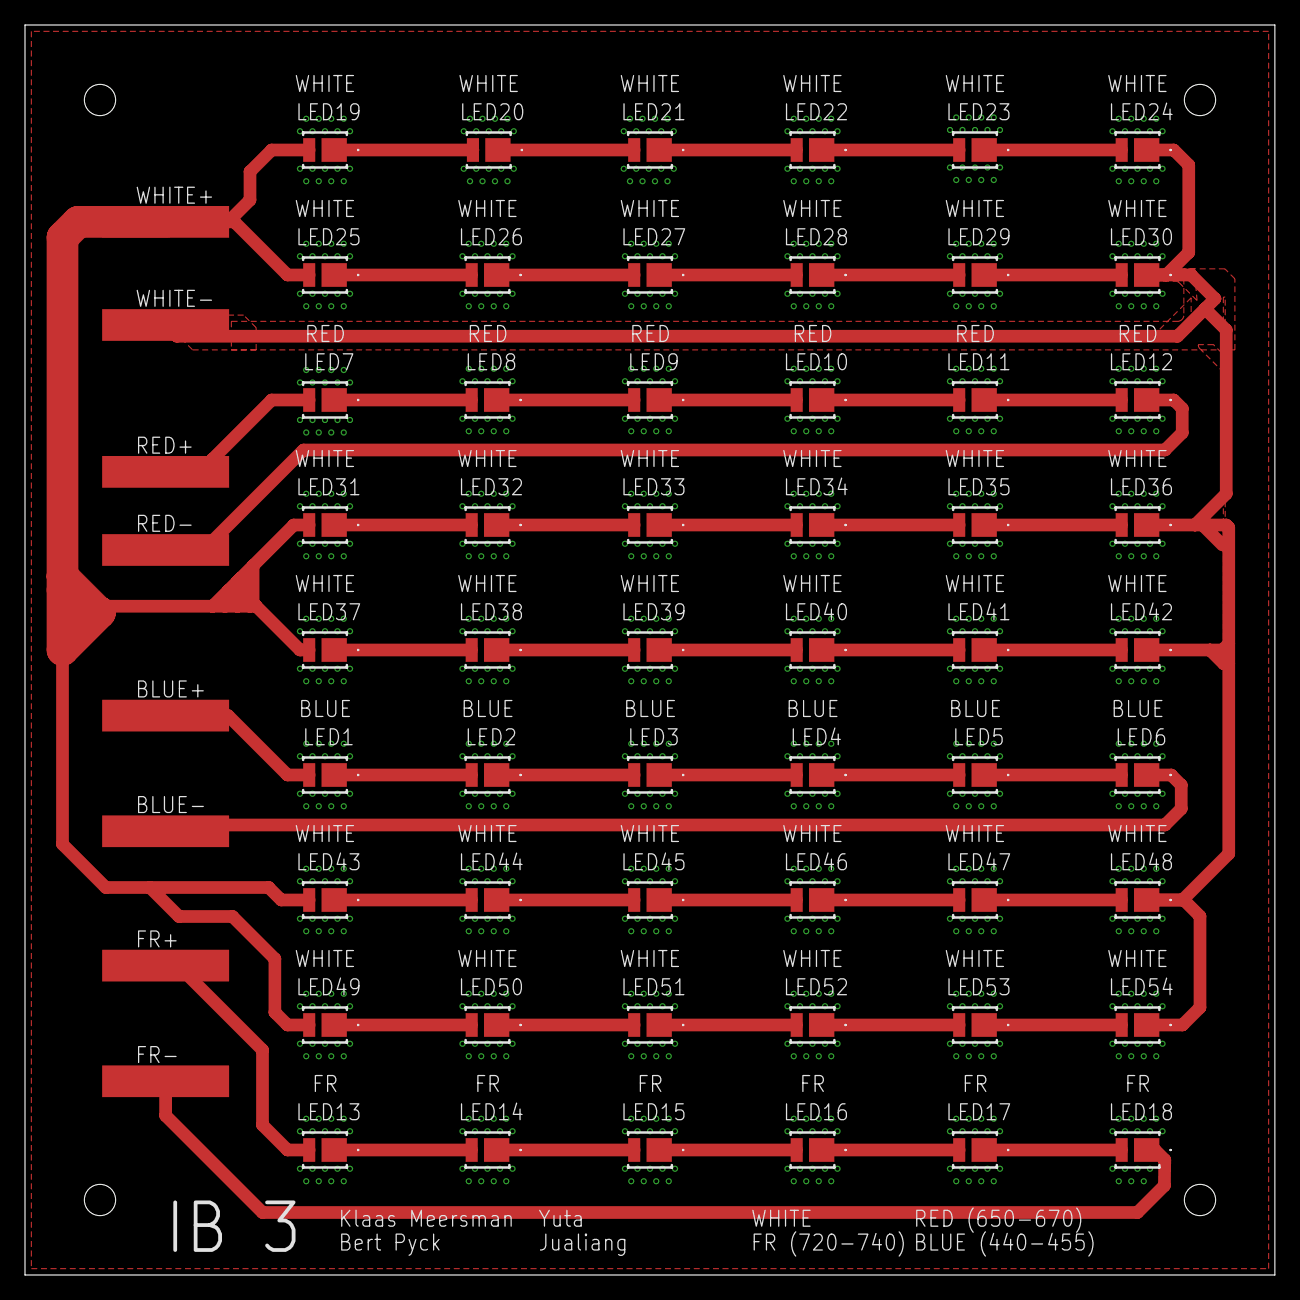
[picture p68: board YutaAndJialiang v19.brd from above]

Board: 2 copper layers, 100.0 x 100.0 mm, 62 parts (0 on the bottom side), 53 nets.
