VerticalFarmIB3/VerticalFarmIB3.github.io/inhoud/leds/eaglefiles/muneeb/muneeb v6.brd

## EAGLE design inhoud/leds/eaglefiles/muneeb/muneeb v6.brd (2024-05-24)

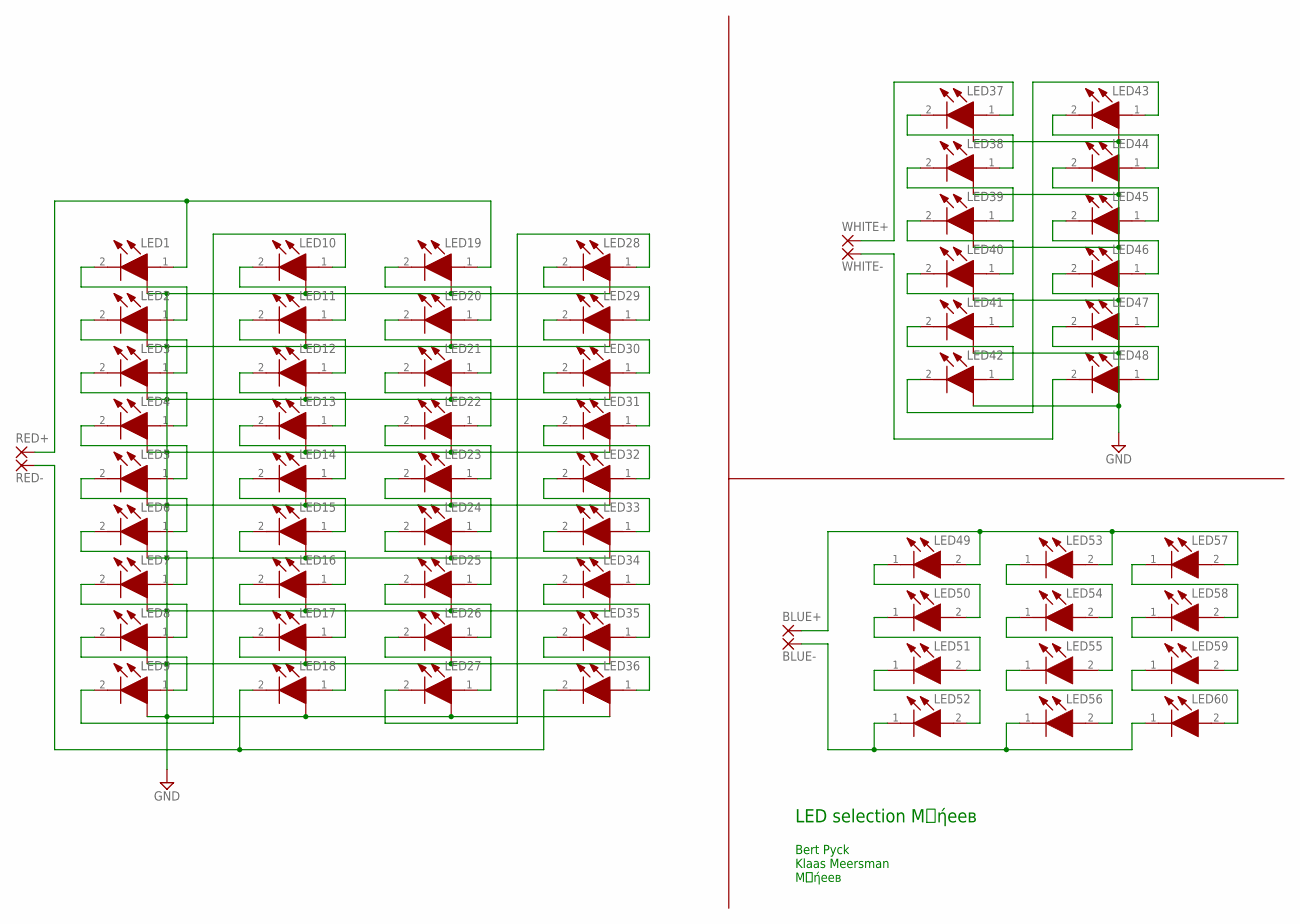
[picture p69: schematic muneeb_v3.sch]

Parts:
BLUE+: SOLDERPAD
BLUE-: SOLDERPAD
LED1, LED2, LED3, LED4, LED5, LED6, LED7, LED8, LED9, LED10, LED11, LED12, LED13, LED14, LED15, LED16, LED17, LED18, LED19, LED20, LED21, LED22, LED23, LED24, LED25, LED26, LED27, LED28, LED29, LED30, LED31, LED32, LED33, LED34, LED35, LED36: RED; GR_CSSRML.24
LED37, LED38, LED39, LED40, LED41, LED42, LED43, LED44, LED45, LED46, LED47, LED48: WHITE; GR_CSSRML.24
LED49, LED50, LED51, LED52, LED53, LED54, LED55, LED56, LED57, LED58, LED59, LED60: BLUE; GD_JTLPSI1.14
RED+: SOLDERPAD
RED-: SOLDERPAD
WHITE+: SOLDERPAD
WHITE-: SOLDERPAD

Connections:
GND: LED1.GND, LED1.P$1 (GND), LED1.P$3 (GND), LED1.P$5 (GND), LED1.P$6 (GND), LED1.P$7 (GND), LED1.P$8 (GND), LED1.P$9 (GND), LED1.P$11 (GND), LED1.P$12 (GND), LED1.P$13 (GND), LED1.P$14 (GND), LED1.P$15 (GND), LED2.GND, LED2.P$1 (GND), LED2.P$3 (GND), LED2.P$5 (GND), LED2.P$6 (GND), LED2.P$7 (GND)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
unnamed: LED1.1 (A), LED19.1 (A), RED+.1
unnamed: LED1.2 (K), LED2.1 (A)
unnamed: LED37.1 (A), WHITE+.1
unnamed: LED48.2 (K), WHITE-.1
unnamed: LED37.2 (K), LED38.1 (A)
unnamed: LED38.2 (K), LED39.1 (A)
unnamed: LED39.2 (K), LED40.1 (A)
unnamed: LED40.2 (K), LED41.1 (A)
unnamed: LED41.2 (K), LED42.1 (A)
unnamed: LED42.2 (K), LED43.1 (A)
unnamed: LED2.2 (K), LED3.1 (A)
unnamed: LED3.2 (K), LED4.1 (A)
unnamed: LED4.2 (K), LED5.1 (A)
unnamed: LED5.2 (K), LED6.1 (A)
unnamed: LED6.2 (K), LED7.1 (A)
unnamed: LED43.2 (K), LED44.1 (A)
unnamed: LED44.2 (K), LED45.1 (A)
unnamed: LED45.2 (K), LED46.1 (A)
unnamed: LED46.2 (K), LED47.1 (A)
unnamed: BLUE+.1, LED49.2 (A), LED53.2 (A), LED57.2 (A)
unnamed: LED7.2 (K), LED8.1 (A)
unnamed: BLUE-.1, LED52.1 (K), LED56.1 (K), LED60.1 (K)
unnamed: LED8.2 (K), LED9.1 (A)
unnamed: LED10.2 (K), LED11.1 (A)
unnamed: LED11.2 (K), LED12.1 (A)
unnamed: LED12.2 (K), LED13.1 (A)
unnamed: LED13.2 (K), LED14.1 (A)
unnamed: LED49.1 (K), LED50.2 (A)
unnamed: LED19.2 (K), LED20.1 (A)
unnamed: LED20.2 (K), LED21.1 (A)
unnamed: LED50.1 (K), LED51.2 (A)
unnamed: LED51.1 (K), LED52.2 (A)
unnamed: LED53.1 (K), LED54.2 (A)
unnamed: LED14.2 (K), LED15.1 (A)
unnamed: LED15.2 (K), LED16.1 (A)
unnamed: LED16.2 (K), LED17.1 (A)
unnamed: LED17.2 (K), LED18.1 (A)
unnamed: LED54.1 (K), LED55.2 (A)
unnamed: LED55.1 (K), LED56.2 (A)
unnamed: LED57.1 (K), LED58.2 (A)
unnamed: LED58.1 (K), LED59.2 (A)
unnamed: LED59.1 (K), LED60.2 (A)
unnamed: LED47.2 (K), LED48.1 (A)
unnamed: LED18.2 (K), LED36.2 (K), RED-.1
unnamed: LED9.2 (K), LED10.1 (A)
unnamed: LED21.2 (K), LED22.1 (A)
unnamed: LED22.2 (K), LED23.1 (A)
unnamed: LED23.2 (K), LED24.1 (A)
unnamed: LED24.2 (K), LED25.1 (A)
unnamed: LED25.2 (K), LED26.1 (A)
unnamed: LED26.2 (K), LED27.1 (A)
unnamed: LED28.2 (K), LED29.1 (A)
unnamed: LED29.2 (K), LED30.1 (A)
unnamed: LED30.2 (K), LED31.1 (A)
unnamed: LED31.2 (K), LED32.1 (A)
unnamed: LED32.2 (K), LED33.1 (A)
unnamed: LED33.2 (K), LED34.1 (A)
unnamed: LED34.2 (K), LED35.1 (A)
unnamed: LED35.2 (K), LED36.1 (A)
unnamed: LED27.2 (K), LED28.1 (A)

Notes on the sheet:
LED selection M𝔲ήeeв
Bert Pyck Klaas Meersman M𝔲ήeeв

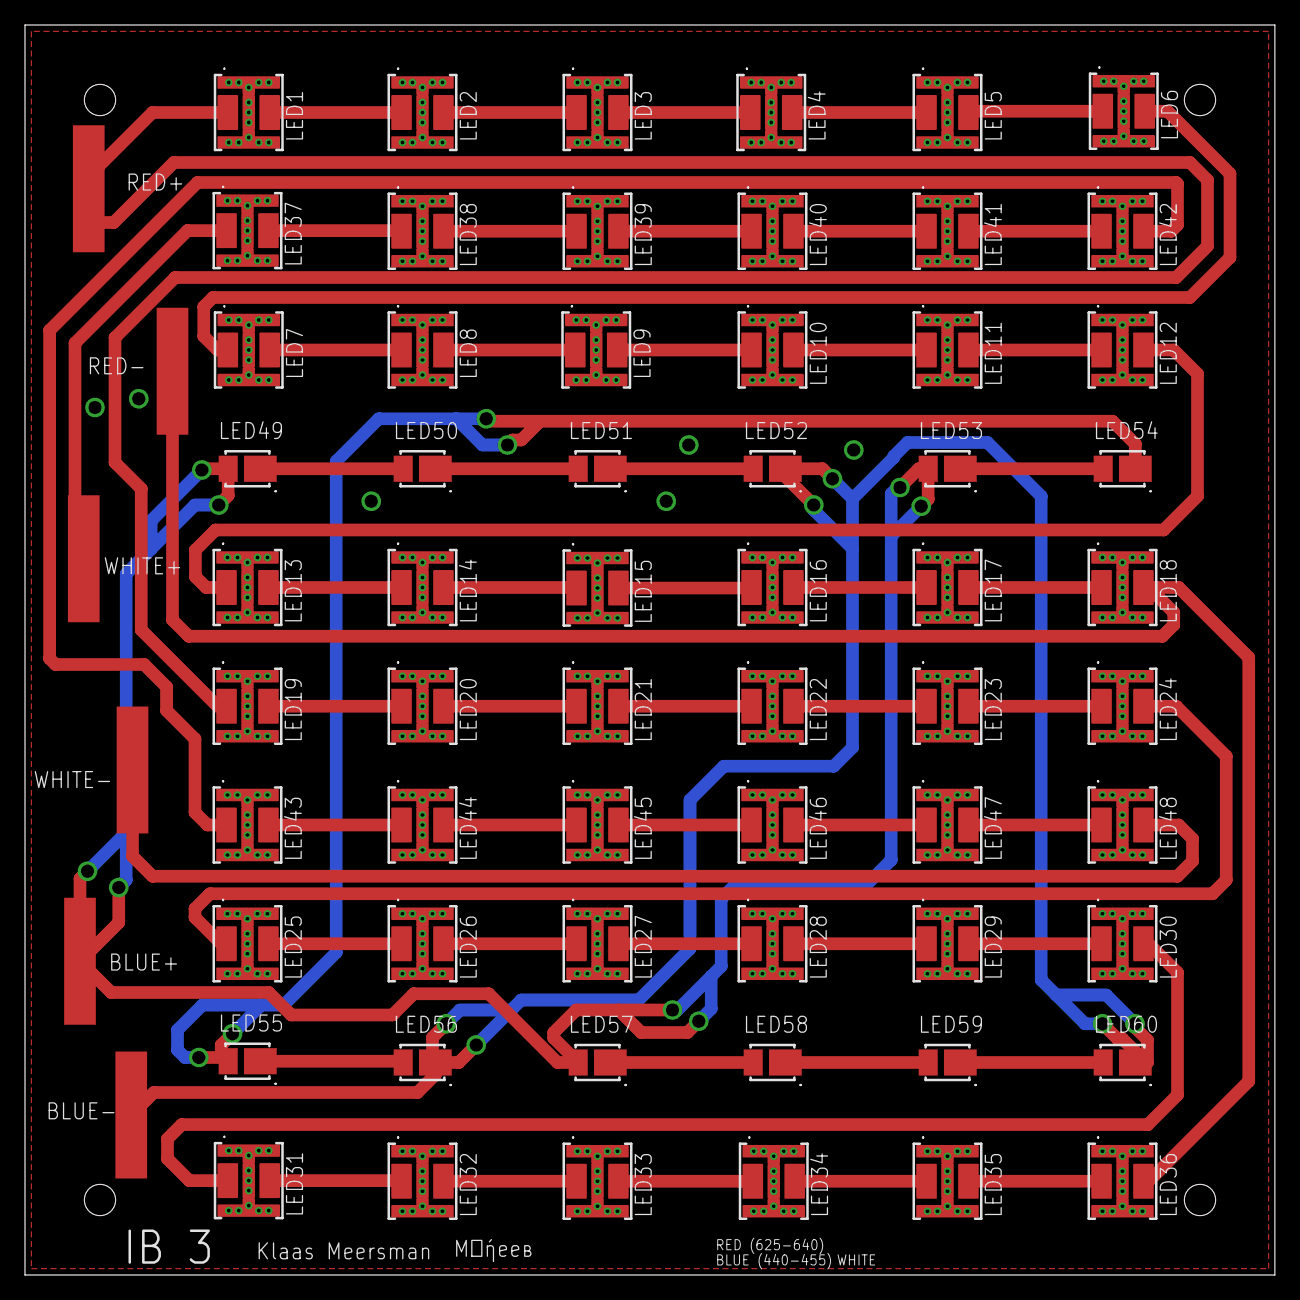
[picture p70: board muneeb v6.brd from above]

Board: 2 copper layers, 100.0 x 100.0 mm, 66 parts (0 on the bottom side), 61 nets.
