VerticalFarmIB3/VerticalFarmIB3.github.io/inhoud/energiemonitoring/PCBs Bert (Type1, Type2, Powerlogger)/PowerLogger/PowerloggerBrd.brd

## EAGLE design inhoud/energiemonitoring/PCBs Bert (Type1, Type2, Powerlogger)/PowerLogger/PowerloggerBrd.brd (2024-05-18)

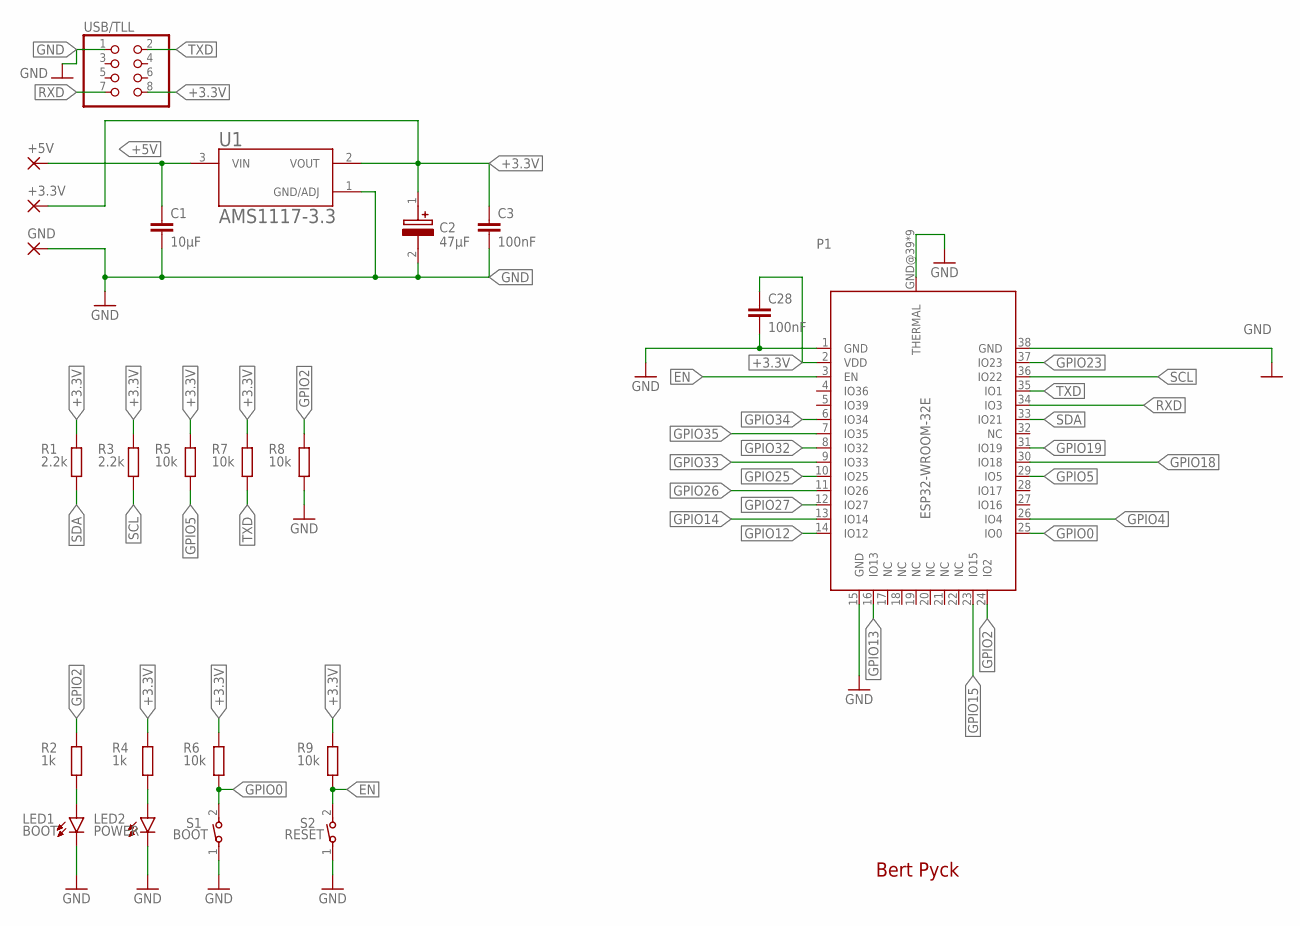
[picture p71: schematic PowerloggerSch.sch, sheet 1]

Parts:
+3.3V, +5V: SOLDERPAD
C1: 10µF; C1206
C2: 47µF; CAPAE660X550N
C3, C28: 100nF; C1206
GND: SOLDERPAD
LED1: BOOT; CHIPLED_1206
LED2: POWER; CHIPLED_1206
P1: ESP32-WROOM-32E
R1, R3: 2.2k; R1206
R2, R4: 1k; R1206
R5, R6, R7, R8, R9: 10k; R1206
S1: BOOT; 434111043826
S2: RESET; 434111043826
U1: AMS1117-3.3; SOT229P700X180-4N
USB/TLL: PINHD-2X4; 2X04

Connections:
+3.3V: +3.3V.1, C2.1 (+), C3.1, C28.1, P1.2 (VDD), R1.2, R3.2, R4.2, R5.2, R6.2, R7.2, R9.2, U1.2 (VOUT), USB/TLL.8; also elsewhere on the board
+5V: +5V.1, C1.1, U1.3 (VIN); also elsewhere on the board
EN: P1.3 (EN), R9.1, S2.2
GND: C1.2, C2.2 (-), C3.2, C28.2, GND.1, LED1.C, LED2.C, P1.1 (GND), P1.15 (GND), P1.38 (GND), P1.GND@39 (THERMAL), P1.GND@40 (THERMAL), P1.GND@41 (THERMAL), P1.GND@42 (THERMAL), P1.GND@43 (THERMAL), P1.GND@44 (THERMAL), P1.GND@45 (THERMAL), P1.GND@46 (THERMAL), P1.GND@47 (THERMAL), R8.1, S1.1, S2.1, U1.1 (GND/ADJ), USB/TLL.1; also elsewhere on the board
GPIO0: P1.25 (IO0), R6.1, S1.2
GPIO2: P1.24 (IO2), R2.2, R8.2
GPIO4: P1.26 (IO4)
GPIO5: P1.29 (IO5), R5.1
GPIO12: P1.14 (IO12)
GPIO13: P1.16 (IO13)
GPIO14: P1.13 (IO14)
GPIO15: P1.23 (IO15)
GPIO18: P1.30 (IO18); also elsewhere on the board
GPIO19: P1.31 (IO19); also elsewhere on the board
GPIO23: P1.37 (IO23); also elsewhere on the board
GPIO25: P1.10 (IO25)
GPIO26: P1.11 (IO26)
GPIO27: P1.12 (IO27)
GPIO32: P1.8 (IO32)
GPIO33: P1.9 (IO33)
GPIO34: P1.6 (IO34)
GPIO35: P1.7 (IO35)
unnamed: LED1.A, R2.1
unnamed: LED2.A, R4.1
RXD: P1.34 (IO3), USB/TLL.7
SCL: P1.36 (IO22), R3.1; also elsewhere on the board
SDA: P1.33 (IO21), R1.1; also elsewhere on the board
TXD: P1.35 (IO1), R7.1, USB/TLL.2

Notes on the sheet:
Bert Pyck

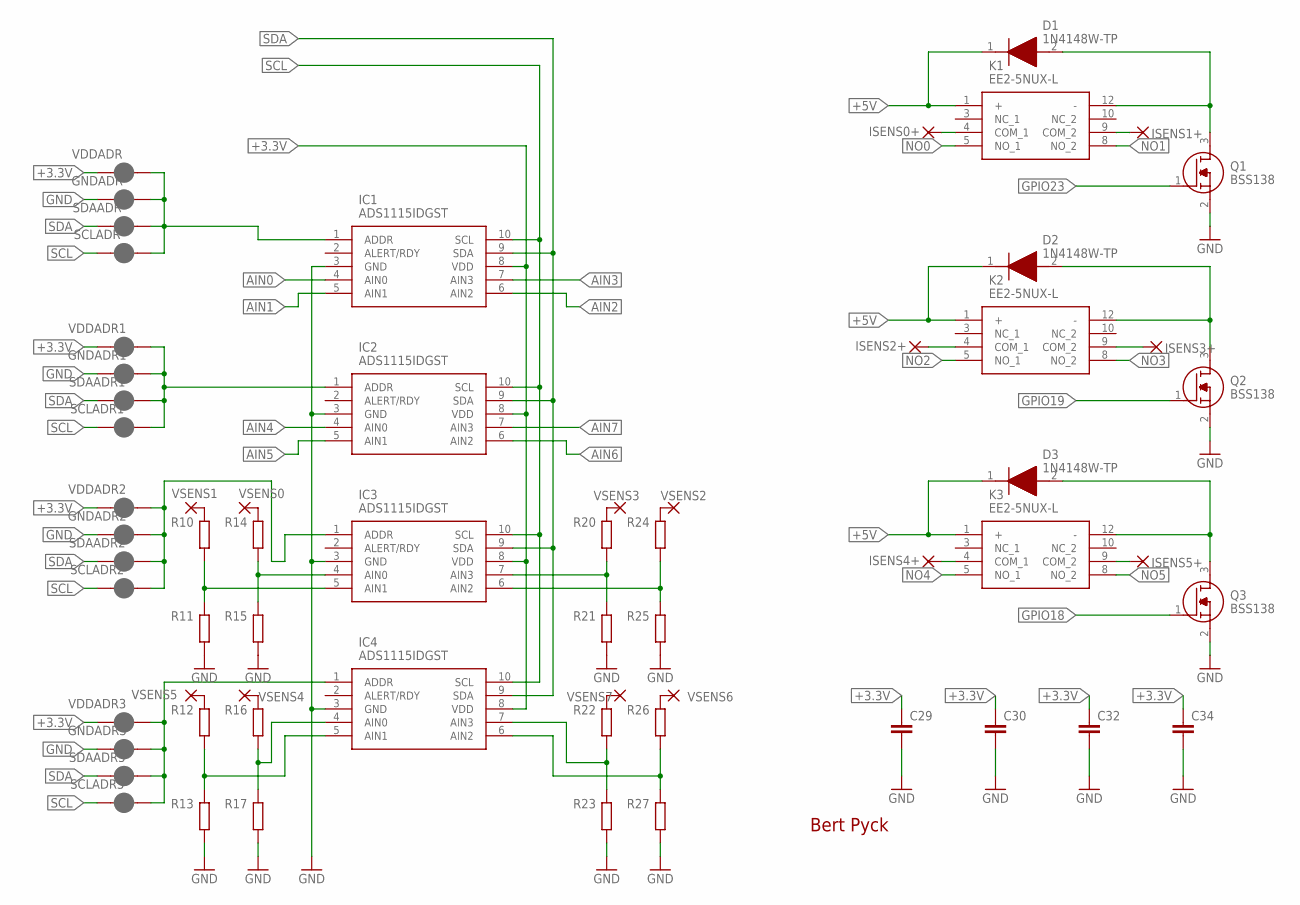
[picture p72: schematic PowerloggerSch.sch, sheet 2]

Parts:
C29, C30, C32, C34: 100nF; C1206
D1, D2, D3: 1N4148W-TP; SOD3715X135N
GNDADR, GNDADR1, GNDADR2, GNDADR3: JUMPER-SMT_2_NC_PASTE_SILK; SMT-JUMPER_2_NC_PASTE_SILK
IC1, IC2, IC3, IC4: ADS1115IDGST; SOP50P490X110-10N
ISENS0+, ISENS1+, ISENS2+, ISENS3+, ISENS4+, ISENS5+: SOLDERPAD
K1, K2, K3: EE2-5NUX-L; EE25NUXL
Q1, Q2, Q3: BSS138; SOT95P240X120-3N
R10, R11, R12, R13, R14, R15, R16, R17, R20, R21, R22, R23, R24, R25, R26, R27: R-EU_R1206; R1206
SCLADR, SCLADR1, SCLADR2, SCLADR3: JUMPER-SMT_2_NC_PASTE_SILK; SMT-JUMPER_2_NC_PASTE_SILK
SDAADR, SDAADR1, SDAADR2, SDAADR3: JUMPER-SMT_2_NC_PASTE_SILK; SMT-JUMPER_2_NC_PASTE_SILK
VDDADR, VDDADR1, VDDADR2, VDDADR3: JUMPER-SMT_2_NC_PASTE_SILK; SMT-JUMPER_2_NC_PASTE_SILK
VSENS0, VSENS1, VSENS2, VSENS3, VSENS4, VSENS5, VSENS6, VSENS7: SOLDERPAD

Connections:
+3.3V: C29.1, C30.1, C32.1, C34.1, IC1.8 (VDD), IC2.8 (VDD), IC3.8 (VDD), IC4.8 (VDD), VDDADR.1, VDDADR1.1, VDDADR2.1, VDDADR3.1; also elsewhere on the board
+5V: D1.1 (K), D2.1 (K), D3.1 (K), K1.1 (+), K2.1 (+), K3.1 (+); also elsewhere on the board
AIN0: IC1.4 (AIN0); also elsewhere on the board
AIN1: IC1.5 (AIN1); also elsewhere on the board
AIN2: IC1.6 (AIN2); also elsewhere on the board
AIN3: IC1.7 (AIN3); also elsewhere on the board
AIN4: IC2.4 (AIN0); also elsewhere on the board
AIN5: IC2.5 (AIN1); also elsewhere on the board
AIN6: IC2.6 (AIN2); also elsewhere on the board
AIN7: IC2.7 (AIN3); also elsewhere on the board
GND: C29.2, C30.2, C32.2, C34.2, GNDADR.1, GNDADR1.1, GNDADR2.1, GNDADR3.1, IC1.3 (GND), IC2.3 (GND), IC3.3 (GND), IC4.3 (GND), Q1.2 (S), Q2.2 (S), Q3.2 (S), R11.1, R13.1, R15.1, R17.1, R21.1, R23.1, R25.1, R27.1; also elsewhere on the board
GPIO18: Q3.1 (G); also elsewhere on the board
GPIO19: Q2.1 (G); also elsewhere on the board
GPIO23: Q1.1 (G); also elsewhere on the board
unnamed: D1.2 (A), K1.12 (-), Q1.3 (D)
unnamed: ISENS0+.1, K1.4 (COM_1)
unnamed: ISENS2+.1, K2.4 (COM_1)
unnamed: IC3.4 (AIN0), R14.1, R15.2
unnamed: ISENS1+.1, K1.9 (COM_2)
unnamed: ISENS3+.1, K2.9 (COM_2)
unnamed: D2.2 (A), K2.12 (-), Q2.3 (D)
unnamed: IC3.5 (AIN1), R10.1, R11.2
unnamed: IC4.4 (AIN0), R16.1, R17.2
unnamed: IC4.5 (AIN1), R12.1, R13.2
unnamed: IC3.7 (AIN3), R20.1, R21.2
unnamed: IC3.6 (AIN2), R24.1, R25.2
unnamed: IC4.7 (AIN3), R22.1, R23.2
unnamed: D3.2 (A), K3.12 (-), Q3.3 (D)
unnamed: IC4.6 (AIN2), R26.1, R27.2
unnamed: ISENS4+.1, K3.4 (COM_1)
unnamed: R10.2, VSENS1.1
unnamed: R14.2, VSENS0.1
unnamed: ISENS5+.1, K3.9 (COM_2)
unnamed: R20.2, VSENS3.1
unnamed: GNDADR.2, IC1.1 (ADDR), SCLADR.2, SDAADR.2, VDDADR.2
unnamed: GNDADR1.2, IC2.1 (ADDR), SCLADR1.2, SDAADR1.2, VDDADR1.2
unnamed: R24.2, VSENS2.1
unnamed: R12.2, VSENS5.1
unnamed: R16.2, VSENS4.1
unnamed: R22.2, VSENS7.1
unnamed: R26.2, VSENS6.1
unnamed: GNDADR3.2, IC4.1 (ADDR), SCLADR3.2, SDAADR3.2, VDDADR3.2
unnamed: GNDADR2.2, IC3.1 (ADDR), SCLADR2.2, SDAADR2.2, VDDADR2.2
NO0: K1.5 (NO_1); also elsewhere on the board
NO1: K1.8 (NO_2); also elsewhere on the board
NO2: K2.5 (NO_1); also elsewhere on the board
NO3: K2.8 (NO_2); also elsewhere on the board
NO4: K3.5 (NO_1); also elsewhere on the board
NO5: K3.8 (NO_2); also elsewhere on the board
SCL: IC1.10 (SCL), IC2.10 (SCL), IC3.10 (SCL), IC4.10 (SCL), SCLADR.1, SCLADR1.1, SCLADR2.1, SCLADR3.1; also elsewhere on the board
SDA: IC1.9 (SDA), IC2.9 (SDA), IC3.9 (SDA), IC4.9 (SDA), SDAADR.1, SDAADR1.1, SDAADR2.1, SDAADR3.1; also elsewhere on the board

Notes on the sheet:
Bert Pyck

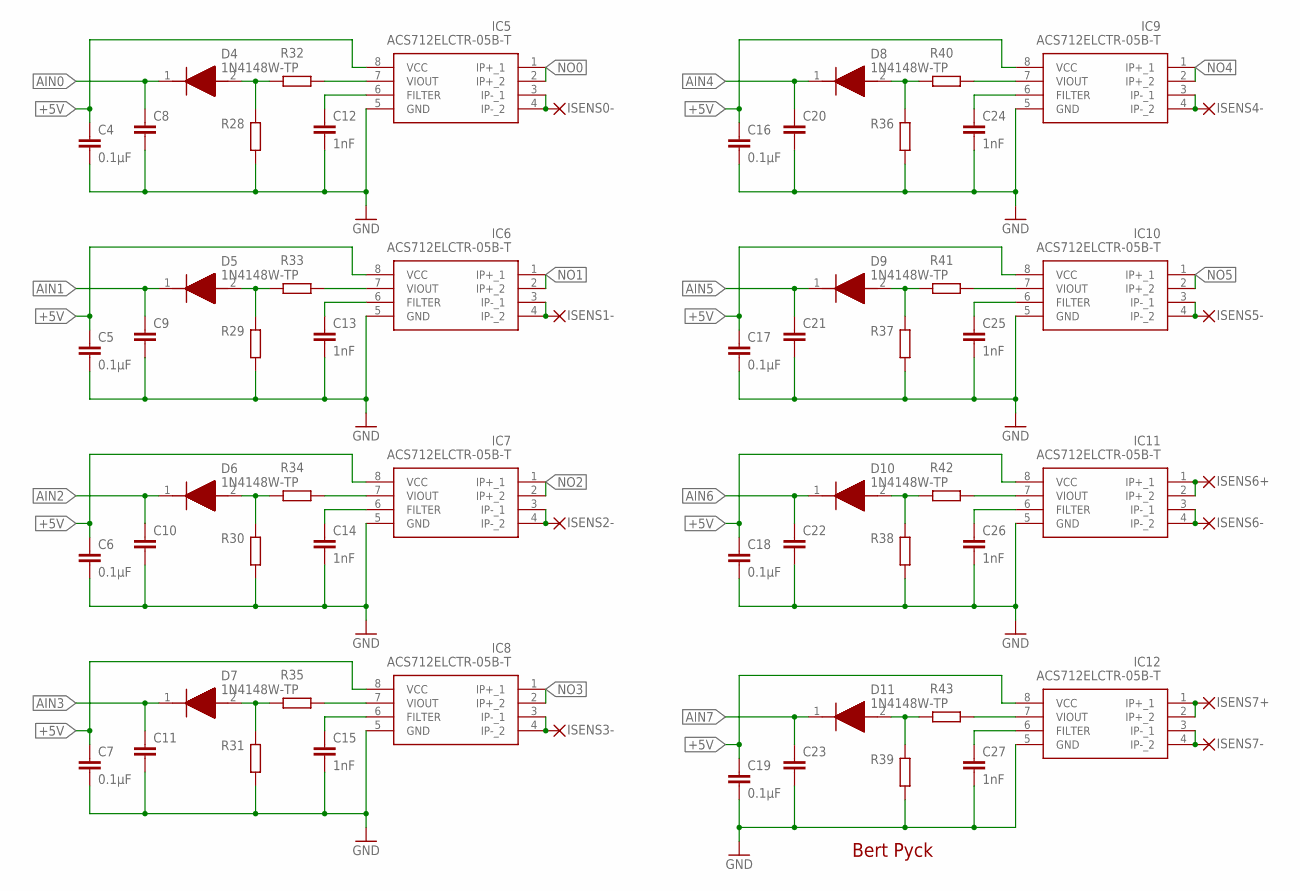
[picture p73: schematic PowerloggerSch.sch, sheet 3]

Parts:
C4, C5, C6, C7, C16, C17, C18, C19: 0.1µF; C1206
C8, C9, C10, C11, C20, C21, C22, C23: C-EUC1206; C1206
C12, C13, C14, C15, C24, C25, C26, C27: 1nF; C1206
D4, D5, D6, D7, D8, D9, D10, D11: 1N4148W-TP; SOD3715X135N
IC5, IC6, IC7, IC8, IC9, IC10, IC11, IC12: ACS712ELCTR-05B-T; SOIC127P600X175-8N
ISENS0-, ISENS1-, ISENS2-, ISENS3-, ISENS4-, ISENS5-, ISENS6+, ISENS6-, ISENS7+, ISENS7-: SOLDERPAD
R28, R29, R30, R31, R32, R33, R34, R35, R36, R37, R38, R39, R40, R41, R42, R43: R-EU_R1206; R1206

Connections:
+5V: C4.1, C5.1, C6.1, C7.1, C16.1, C17.1, C18.1, C19.1, IC5.8 (VCC), IC6.8 (VCC), IC7.8 (VCC), IC8.8 (VCC), IC9.8 (VCC), IC10.8 (VCC), IC11.8 (VCC), IC12.8 (VCC); also elsewhere on the board
AIN0: C8.1, D4.1 (K); also elsewhere on the board
AIN1: C9.1, D5.1 (K); also elsewhere on the board
AIN2: C10.1, D6.1 (K); also elsewhere on the board
AIN3: C11.1, D7.1 (K); also elsewhere on the board
AIN4: C20.1, D8.1 (K); also elsewhere on the board
AIN5: C21.1, D9.1 (K); also elsewhere on the board
AIN6: C22.1, D10.1 (K); also elsewhere on the board
AIN7: C23.1, D11.1 (K); also elsewhere on the board
GND: C4.2, C5.2, C6.2, C7.2, C8.2, C9.2, C10.2, C11.2, C12.2, C13.2, C14.2, C15.2, C16.2, C17.2, C18.2, C19.2, C20.2, C21.2, C22.2, C23.2, C24.2, C25.2, C26.2, C27.2, IC5.5 (GND), IC6.5 (GND), IC7.5 (GND), IC8.5 (GND), IC9.5 (GND), IC10.5 (GND), IC11.5 (GND), IC12.5 (GND), R28.1, R29.1, R30.1, R31.1, R36.1, R37.1, R38.1, R39.1; also elsewhere on the board
unnamed: C12.1, IC5.6 (FILTER)
unnamed: IC5.7 (VIOUT), R32.1
unnamed: D4.2 (A), R28.2, R32.2
unnamed: C13.1, IC6.6 (FILTER)
unnamed: IC5.3 (IP-_1), IC5.4 (IP-_2), ISENS0-.1
unnamed: IC6.7 (VIOUT), R33.1
unnamed: D5.2 (A), R29.2, R33.2
unnamed: IC6.3 (IP-_1), IC6.4 (IP-_2), ISENS1-.1
unnamed: C14.1, IC7.6 (FILTER)
unnamed: IC7.7 (VIOUT), R34.1
unnamed: D6.2 (A), R30.2, R34.2
unnamed: IC7.3 (IP-_1), IC7.4 (IP-_2), ISENS2-.1
unnamed: C15.1, IC8.6 (FILTER)
unnamed: IC8.7 (VIOUT), R35.1
unnamed: D7.2 (A), R31.2, R35.2
unnamed: IC8.3 (IP-_1), IC8.4 (IP-_2), ISENS3-.1
unnamed: C24.1, IC9.6 (FILTER)
unnamed: IC9.7 (VIOUT), R40.1
unnamed: D8.2 (A), R36.2, R40.2
unnamed: IC9.3 (IP-_1), IC9.4 (IP-_2), ISENS4-.1
unnamed: C25.1, IC10.6 (FILTER)
unnamed: IC10.7 (VIOUT), R41.1
unnamed: D9.2 (A), R37.2, R41.2
unnamed: IC10.3 (IP-_1), IC10.4 (IP-_2), ISENS5-.1
unnamed: C26.1, IC11.6 (FILTER)
unnamed: IC11.7 (VIOUT), R42.1
unnamed: D10.2 (A), R38.2, R42.2
unnamed: IC11.1 (IP+_1), IC11.2 (IP+_2), ISENS6+.1
unnamed: IC11.3 (IP-_1), IC11.4 (IP-_2), ISENS6-.1
unnamed: C27.1, IC12.6 (FILTER)
unnamed: IC12.7 (VIOUT), R43.1
unnamed: D11.2 (A), R39.2, R43.2
unnamed: IC12.1 (IP+_1), IC12.2 (IP+_2), ISENS7+.1
unnamed: IC12.3 (IP-_1), IC12.4 (IP-_2), ISENS7-.1
NO0: IC5.1 (IP+_1), IC5.2 (IP+_2); also elsewhere on the board
NO1: IC6.1 (IP+_1), IC6.2 (IP+_2); also elsewhere on the board
NO2: IC7.1 (IP+_1), IC7.2 (IP+_2); also elsewhere on the board
NO3: IC8.1 (IP+_1), IC8.2 (IP+_2); also elsewhere on the board
NO4: IC9.1 (IP+_1), IC9.2 (IP+_2); also elsewhere on the board
NO5: IC10.1 (IP+_1), IC10.2 (IP+_2); also elsewhere on the board

Notes on the sheet:
Bert Pyck

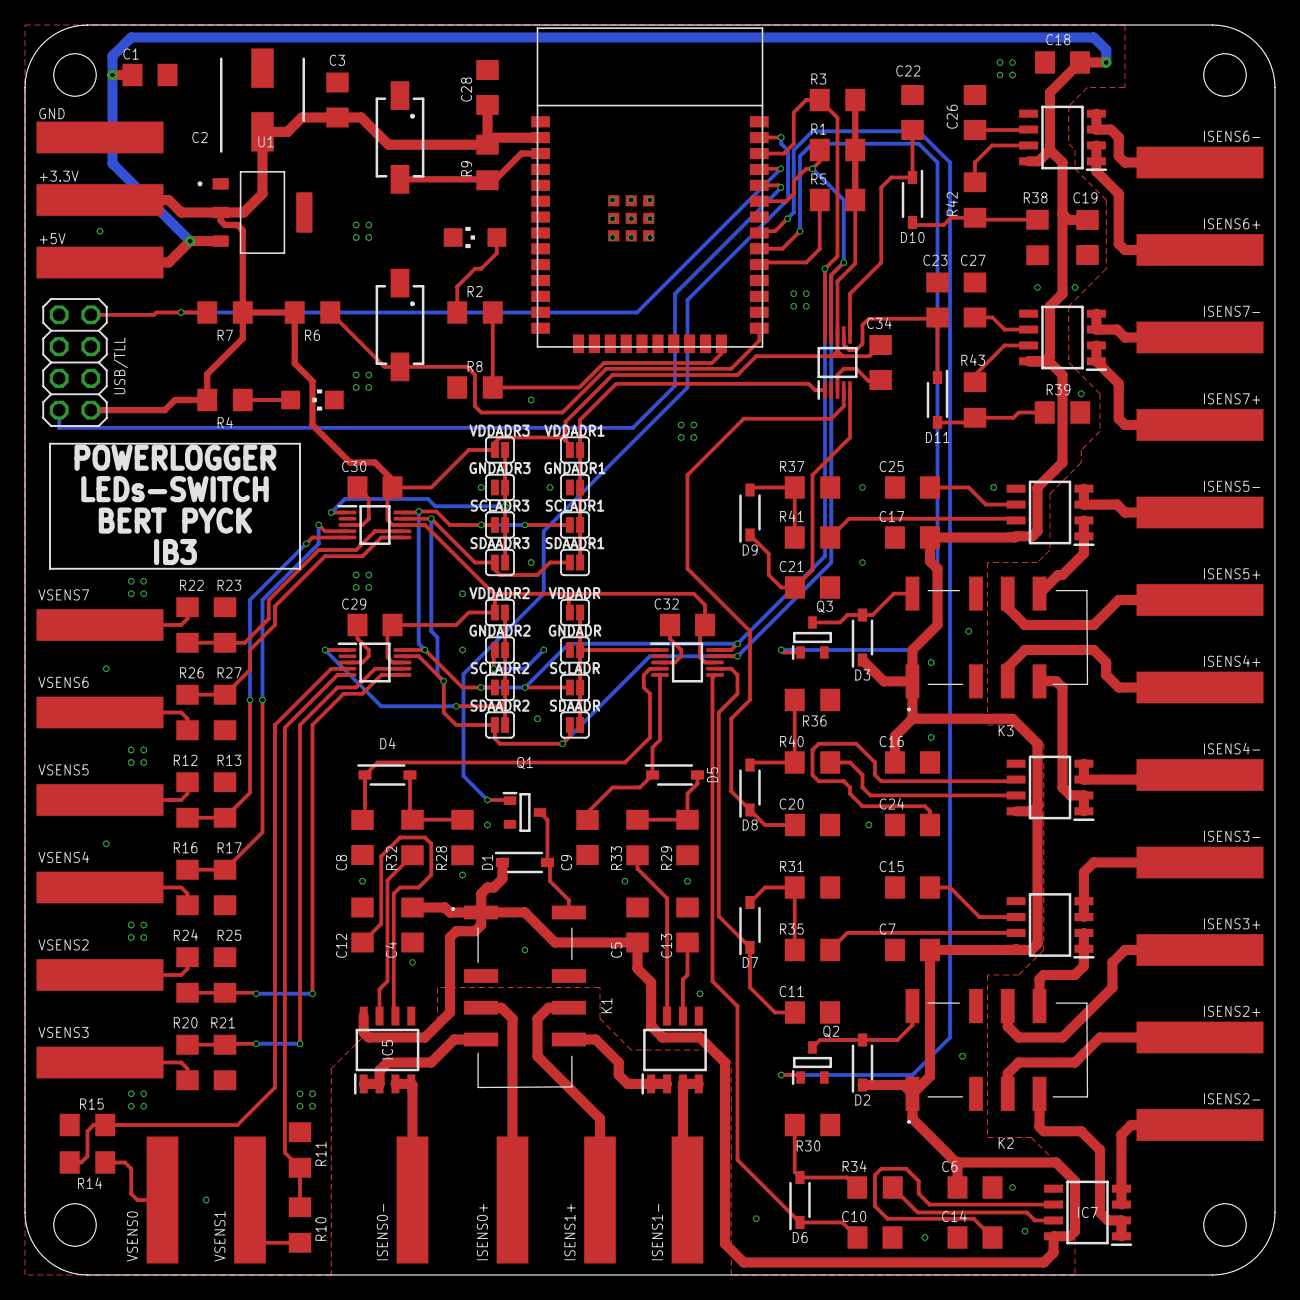
[picture p74: board PowerloggerBrd.brd from above]

Board: 2 copper layers, 100.0 x 100.0 mm, 152 parts (0 on the bottom side), 93 nets.
