VerticalFarmIB3/VerticalFarmIB3.github.io/(commit log)

2024-05-18 initialise plantensensor
    [soil_moister_air.kicad_pcb, soil_moister_air.kicad_sch]
2024-05-18 intialise aansturing leds
    [waarden.xlsx]
2024-05-18 init leds
2024-05-18 initialise energiemonitoring
    [PowerloggerBrd.brd, PowerloggerSch.sch, Type1brd.brd, Type1sch.sch, Type2brd.brd, Type2sch.sch, voltage_sensor.kicad_sch]
2024-05-23 VF IB3 update
    [waarden.xlsx]
2024-05-23 update dashboard
    [config.yaml van homeassistant.txt]
2024-05-24 Revert "delete all to fork"
    This reverts commit 2d5b96d703e90744c07c19ecfc6bb0d3bed4118e.
    [Bestellingslijst.xlsx, PowerloggerBrd.brd, PowerloggerSch.sch, Type1brd.brd, Type1sch.sch, Type2brd.brd, Type2sch.sch, config.yaml van homeassistant.txt]
2024-05-24 update leds
    [YutaAndJialiang v17.sch, YutaAndJialiang v19.brd, muneeb v6.brd, muneeb_v3.sch]
2024-05-24 update plantensensor
    [soil_moister_air-B_Cu.gbr, soil_moister_air-B_Mask.gbr, soil_moister_air-B_Paste.gbr, soil_moister_air-B_Silkscreen.gbr, soil_moister_air-Edge_Cuts.gbr, soil_moister_air-F_Cu.gbr, soil_moister_air-F_Mask.gbr, soil_moister_air-F_Paste.gbr]
